penhirai/LinefollowerVerdiRT17_MainPCB/Order/PCBGOGO/20160213/VerdiRT7_MainPCB.jpg

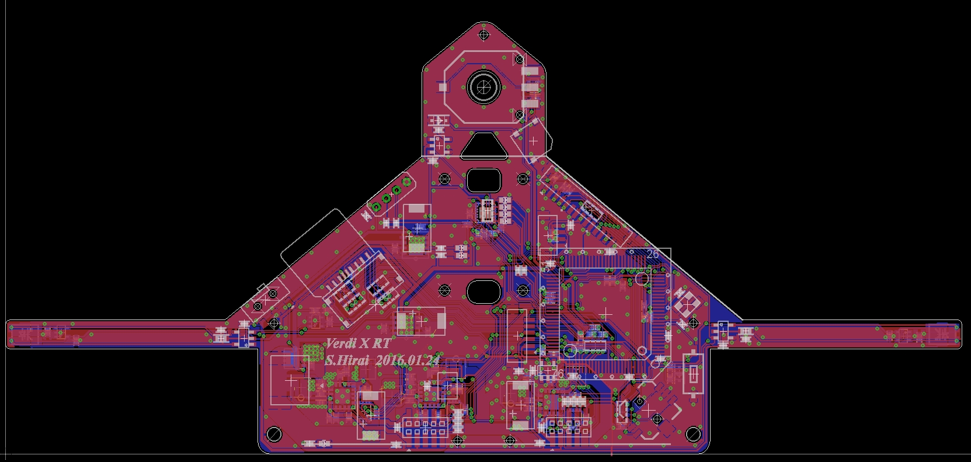
Order/PCBGOGO/20160213/VerdiRT7_MainPCB.jpg
