penhirai/LinefollowerVerdiRT17_MainPCB/README.md

# LinefollowerVerdiRT17_MainPCB
Micromouse Robotrace Competition
