penhirai/LinefollowerVerdiRT17_MainPCB/VerdiRT7_MainPCB_Board.pdf

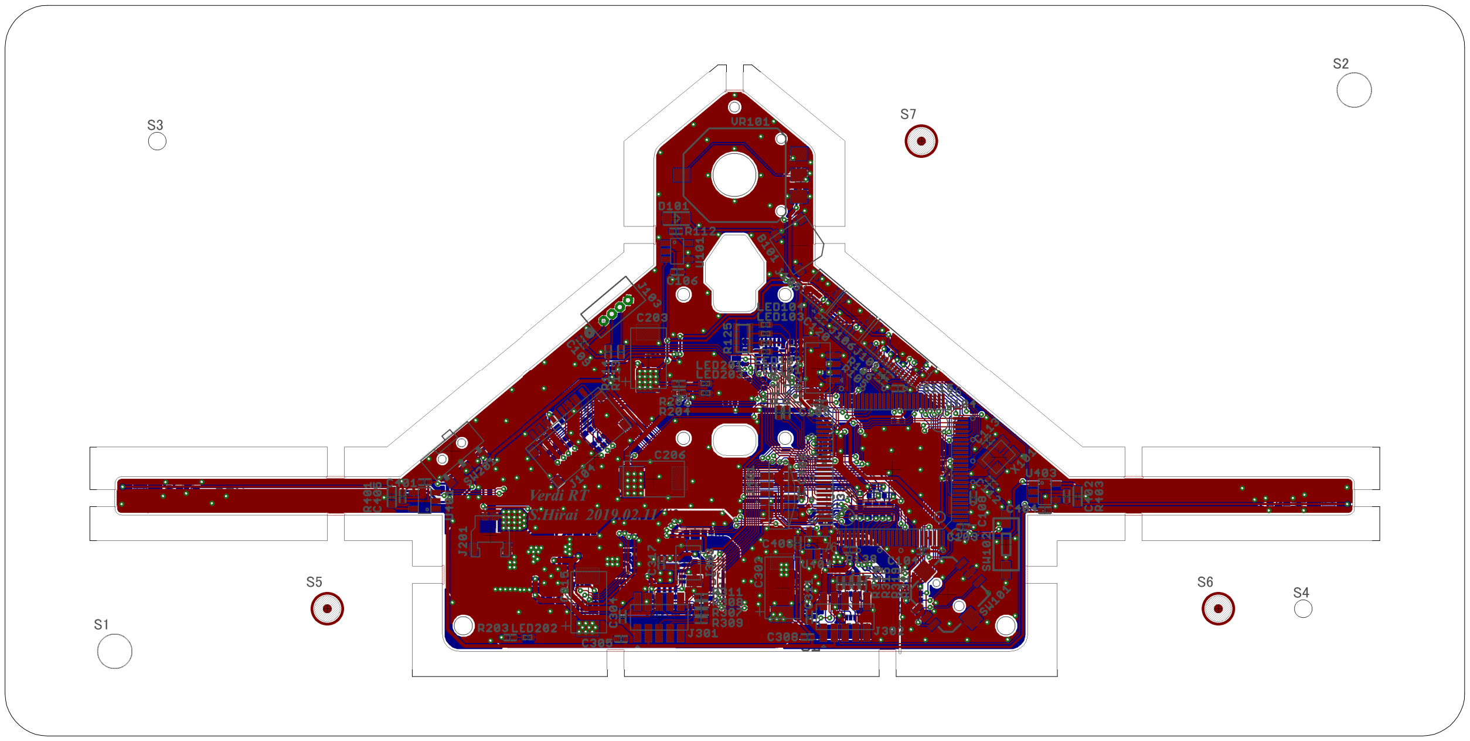
[picture p2: figure]
