penhirai/LinefollowerVerdiRT17_MainPCB/VerdiRT7_MainPCB_GBview_Cmp.png

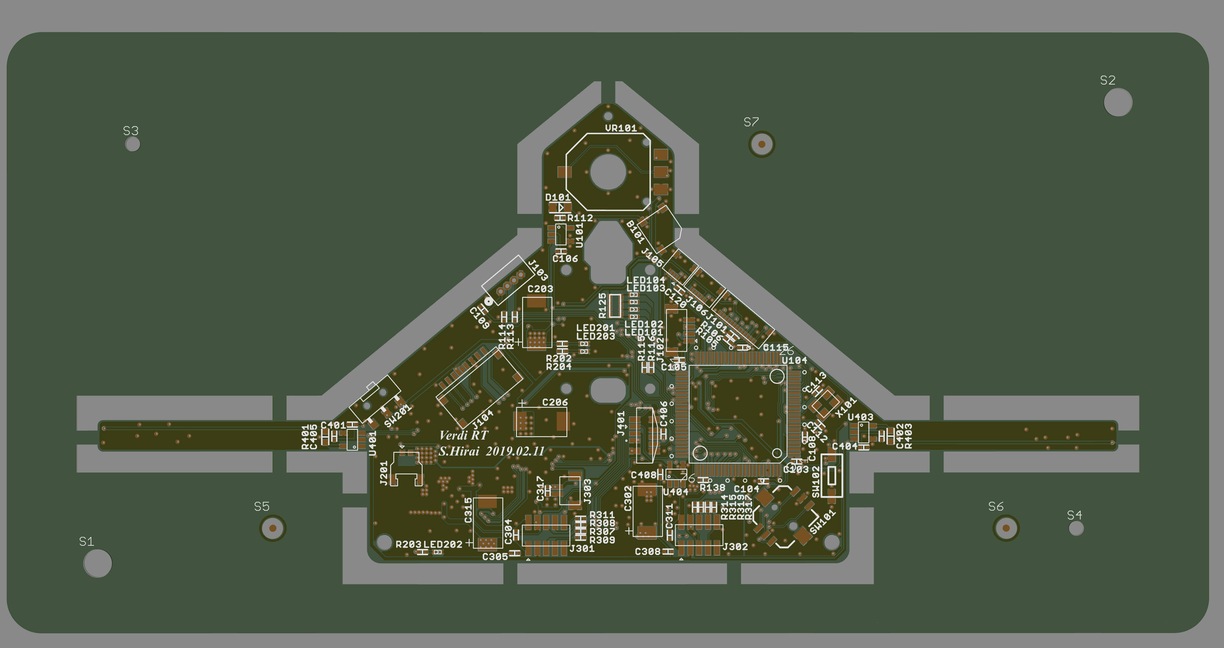
VerdiRT7_MainPCB_GBview_Cmp.png
