penhirai/LinefollowerVerdiRT17_MainPCB/VerdiRT7_MainPCB_GBview_Sol_Mirror.png

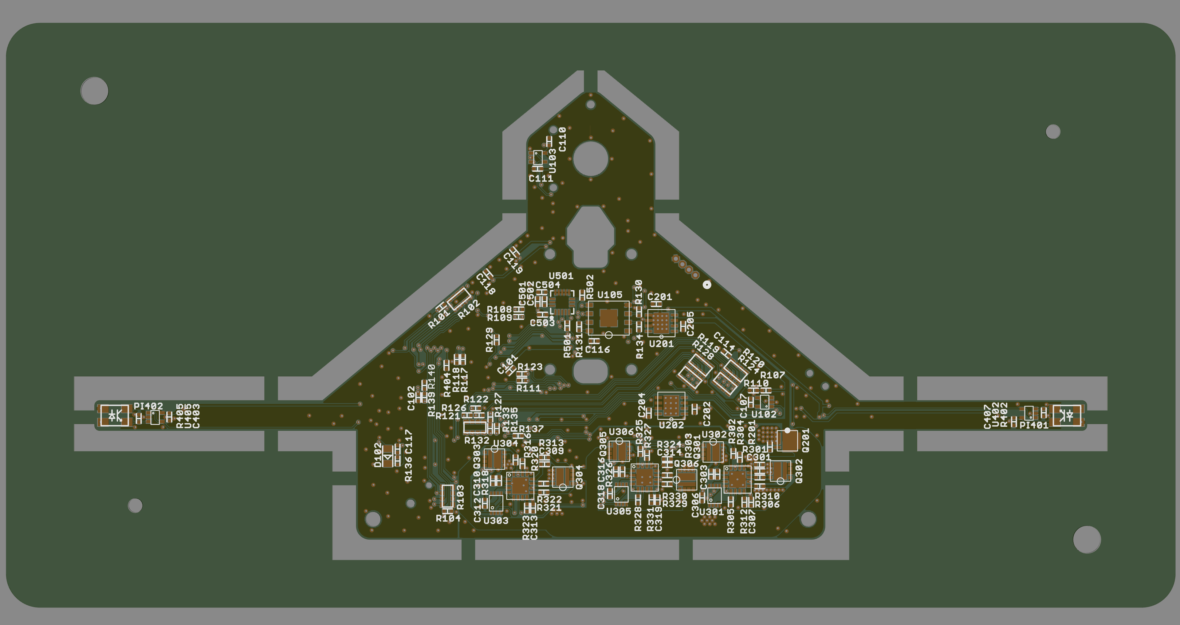
VerdiRT7_MainPCB_GBview_Sol_Mirror.png
