penhirai/LinefollowerVerdiRT17_MainPCB/Order/PCBGOGO/20160213/readme.txt

readme.txt ... 

VerdiRT7_Main.cmp ... pattern component side
VerdiRT7_Main.sol ... pattern solder side
VerdiRT7_Main.stc ... Solder stop component side
VerdiRT7_Main.sts ... Solder stop solder side
VerdiRT7_Main.plc ... Silkscreen component side
VerdiRT7_Main.out ... outline file
VerdiRT7_Main.dri ... Drill table
VerdiRT7_Main.drd ... Drill data

VerdiRT7_Main.jpg ... PCB image
