penhirai/LinefollowerVerdiRT17_MainPCB/Order/PCBGOGO/20190217_Order/Gerber/readme.txt

readme.txt ... 

VerdiRT19_MainPCB.cmp ... pattern component side (L1)
VerdiRT19_MainPCB.sol ... pattern solder side (L2)
VerdiRT19_MainPCB.stc ... Solder stop component side
VerdiRT19_MainPCB.sts ... Solder stop solder side
VerdiRT19_MainPCB.plc ... Silkscreen component side
VerdiRT19_MainPCB.pls ... Silkscreen solder side
VerdiRT19_MainPCB.crc ... Cream component side
VerdiRT19_MainPCB.crs ... Cream solder side
VerdiRT19_MainPCB.out ... outline file
VerdiRT19_MainPCB.dri ... Drill table
VerdiRT19_MainPCB.drd ... Drill data

PositionVerdiRT19_MainPCB.txt ... Mount position component/solder side
BomVerdiRT19_MainPCB.xlsx ... Bom list

VerdiRT19_MainPCB_GBView_Cmp.png        ... Gerber View Component side with Description
VerdiRT19_MainPCB_GBView_Sol_Mirror.png ... Gerber View Solder side with Description

VerdiRT19_MainPCB_Specification.txt ... PCB Specification
