penhirai/LinefollowerVerdiRT17_MainPCB/Order/PCBGOGO/20190217_Order/BomVerdiRT19_MainPCB.xlsx

品名 Name | 部品番号 Designator | 個数 Quantity | 値 Value | パッケージ Package | 説明 Description | 部品メーカー Manufacturer | 部品メーカーの品番 Manufacturer Part Number | 実装 / 非実装 | 代替可否
抵抗 | R112, R304, R308, R310, R311, R315, R317, R320, R322, R327, R330 | 11 | 0 | 1005 |  | KOA | RK73Z1ETTP | 実装 | 可
抵抗 | R307, R309, R314, R319 | 4 | 0 | 1005 |  | KOA | RK73Z1ETTP | 非実装 | 可
抵抗 | R303, R312, R318, R323, R326, R331 | 6 | 1 | 1005 | 1% | KOA | RK73H1ETTP1R00F | 実装 | 可
抵抗 | R103, R119, R120 | 3 | 100k | 3216 | 1% | Bourns | CAT16-1003F4LF | 実装 | 可
抵抗 | R104, R111, R130, R131, R136, R139, R305, R328, R404, R502 | 10 | 100k | 1005 | 1% | KOA | RK73H1ETTP1003F | 実装 | 可
抵抗 | R140 | 1 | 100k | 1005 | 1% | KOA | RK73H1ETTP1003F | 非実装 | 可
コネクタ | J104 | 1 | ー | SMD |  | TE Connectivity | 1050270001 | 実装 | 可
コンデンサ | C101, C102, C103, C104, C105, C107, C108, C109, C110, C111, C114, C115, C116, C201, C204, C306, C312, C318, C401, C403, C404, C406, C407, C408 | 24 | 10V 0.1u | 1005 | 16V X7R 10% | TE Connectivity | GRM155R71C104JA88D | 実装 | 可
コンデンサ | C112, C113 | 2 | 10V 10p | 1005 | 10V CH 10% | TDK | C1005CH1H100C050BA | 実装 | 可
コンデンサ | C106, C117, C118, C120, C305, C308, C402, C405 | 8 | 10V 1u | 1005 | 35V X5R 10% | TDK | C1005X5R1V105K050BC | 実装 | 可
抵抗 | R102, R125 | 2 | 10k | 3216 | 1% | Bourns | CAT16-1002F4LF | 実装 | 可
抵抗 | R101, R105, R106, R110 | 4 | 10k | 1005 | 1% | KOA | RK73H1ETTP1002F | 実装 | 可
コンデンサ | C202, C205 | 2 | 16V 0.1u | 1005 | 16V X7R 10% | Murata | GRM155R71C104JA88D | 実装 | 可
コンデンサ | C119, C301, C303, C307, C309, C310, C313, C314, C316, C319 | 10 | 16V 1u | 1005 | 35V X5R 10% | TDK | C1005X5R1V105K050BC | 実装 | 可
ダイオード | D101, D102 | 2 | ー | 2012 |  | Toshiba | 1SS352 | 実装 | 可
抵抗 | R301, R302, R306, R313, R316, R321, R324, R325, R329 | 9 | 2.2 | 1005 | 1% | KOA | RK73H1ETTP2R20F | ー | 可
コネクタ | J301, J302 | 2 | ー | SMD |  | Amphenol ICC (FCI) | 20021321-00010C4LF | 実装 | 可
抵抗 | R107, R201 | 2 | 20k | 1005 | 1% | KOA | RK73H1ETTP2002F | ー | 可
抵抗 | R108, R109, R113, R114 | 4 | 20k | 1005 | 1% | KOA | RK73H1ETTP2002F | 非実装 | 可
抵抗 | R124, R128, R132 | 3 | 22 | 3216 | 1% | Bourns | CAT16-22R0F4LF | 実装 | 可
抵抗 | R115, R116, R121, R122, R126, R127, R129, R133, R134, R135, R137, R138, R501 | 13 | 22 | 1005 | 1% | KOA | RK73H1ETTP22R0F | 実装 | 可
抵抗 | R117, R118, R123 | 3 | 22 | 1005 | 1% | KOA | RK73H1ETTP22R0F | 非実装 | 可
抵抗 | R402, R405 | 2 | 3k | 1005 | 1% | KOA | RK73H1ETTP3001F | ー | 可
抵抗 | R202, R203, R204 | 3 | 4.7k | 1005 | 1% | KOA | RK73H1ETTP4701F | ー | 可
コネクタ | J105 | 1 | ー | SMD |  | Molex | 503480-0400 | ー | 不可
コネクタ | J106 | 1 | ー | SMD |  | Molex | 503480-0600 | 実装 | 不可
コネクタ | J101 | 1 | ー | SMD |  | Molex | 503480-1400 | ー | 不可
コンデンサ | C304, C311, C317 | 3 | 50V 0.01u | 1005 | 50V X7R 10% | Murata | GRM155R71H103KA88D | 実装 | 可
抵抗 | R401, R403 | 2 | 51 | 1608 | 1% | KOA | RK73H1JTTD51R0F | 実装 | 可
コネクタ | J401 | 1 | ー | SMD |  | Molex | 52559-0652 | 実装 | 不可
コンデンサ | C502, C503, C504 | 3 | 6.3V 0.1u | 1005 | 16V X7R 10% | Murata | GRM155R71C104JA88D | 実装 | 可
コンデンサ | C501 | 1 | 6.3V 1u | 1005 | 35V X5R 10% | TDK | C1005X5R1V105K050BC | 実装 | 可
ロジックIC | U301, U303, U305 | 3 | ー | VSSOP8 |  | Nexperia | 74LVC2G08DC | 実装 | 不可
LED | LED101, LED102, LED103, LED104 | 4 | ー | 1005 |  | Kingbright | APHHS1005QBC/D | 実装 | 可
LED | LED201, LED203 | 2 | ー | 1005 |  | Kingbright | APHHS1005SYCK | 実装 | 可
LED | LED202 | 1 | ー | 1005 |  | Kingbright | APHHS1005ZGC | 実装 | 可
スイッチ | SW201 | 1 | ー | SMD |  | C&K | AYZ0102AGRLC | 実装 | 不可
基準穴 | S1, S2 | 2 | ー | ー | BASE_HOLE | ー | BASE_HOLE | ー | ー
コネクタ | J303 | 1 | ー | SMD |  | JST | BM02B-SRSS-TB(LF)(SN) | 実装 | 不可
コネクタ | J102 | 1 | ー | SMD |  | JST | BM04B-SRSS-TB(LF)(SN) | 実装 | 不可
コネクタ | J103 | 1 | ー | SMD |  | Hirose | DF13-4P-1.25DSA | 非実装 | 不可
コネクタ | J201 | 1 | ー | SMD |  | Hirose | DF58-2P-1.2V(21) | 実装 | 不可
コンデンサ | C203, C206, C302, C315 | 4 | 16V 33u | 7343 | 20% | Panasonic | EEF-CS1C330R | 実装 | 不可
フォトインタラプタ | PI401, PI402 | 2 | ー | SMD |  | Sharp | GP2S700HCP | 実装 | 不可
ガイド穴 | S3 | 1 | ー | ー | GUIDE_HOLE_1 | ー | GUIDE_HOLE_1 | ー | ー
ガイド穴 | S4 | 1 | ー | ー | GUIDE_HOLE_2 | ー | GUIDE_HOLE_2 | ー | ー
MEMS ジャイロ | U501 | 1 | ー | LGA16_3X3MM |  | TDK Invensense | ICM-20602 | 実装 | 不可
ゲートドライバ | U101, U401, U403, U404 | 4 | ー | SOT23-5 |  | Microchip | MCP1416T-E/OT | 実装 | 不可
オペアンプ | U102, U103, U402, U405 | 4 | ー | SOT-70-5 |  | Microchip | MCP6001T-I/LT | 実装 | 不可
メモリ | U105 | 1 | ー | 8DFN |  | Everspin | MR20H40CDF | 実装 | 不可
水晶振動子 | X101 | 1 | ー | 3225 |  | NDK | NX3225SA-12.000M-STD-CSR-1 | 実装 | 不可
マイコン | U104 | 1 | ー | TQFP100-16X16 |  | Renesas | R5F564MLDDFP#V1-ND | 実装 | 不可
認識マーク | S5 | 1 | ー | ー | RECOG_MARK_1 | ー | RECOG_MARK_1 | ー | ー
認識マーク | S6 | 1 | ー | ー | RECOG_MARK_2 | ー | RECOG_MARK_2 | ー | ー
認識マーク | S7 | 1 | ー | ー | RECOG_MARK_3 | ー | RECOG_MARK_3 | ー | ー
ゲートドライバ | U302, U304, U306 | 3 | ー | WQFN16 |  | Richtek | RT9625AZQW | 実装 | 不可
MOSFET | Q201 | 1 | ー | POWERPAK1212-8 |  | Vishay | SISA01DN-T1-GE3 | 実装 | 不可
MOSFET | Q301, Q302, Q303, Q304, Q305, Q306 | 6 | ー | DFN3X3A |  | Vishay | SIZ322DT-T1-GE3 | 実装 | 不可
スイッチ | SW102 | 1 | ー | SMD |  | Alps | SKQYACE010 | 実装 | 不可
スイッチ | SW101 | 1 | ー | SMD |  | Alps | SKRHABE010 | 実装 | 不可
ブザー | B101 | 1 | ー | SMD |  | PUI Audio | SMT-0540-T-7-R | 実装 | 不可
可変抵抗 | VR101 | 1 | ー | SMD |  | Murata | SV01A103AEA01 | 実装 | 不可
電源 IC | U202 | 1 | ー | WFDFN8 |  | Texas Instruments | TLV1117-33CDRJR | 実装 | 不可
電源 IC | U201 | 1 | ー | WFDFN8 |  | Texas Instruments | TLV1117-50CDRJR | 実装 | 不可
