penhirai/LinefollowerVerdiRT17_MainPCB/VerdiRT7_MainPCB.pdf

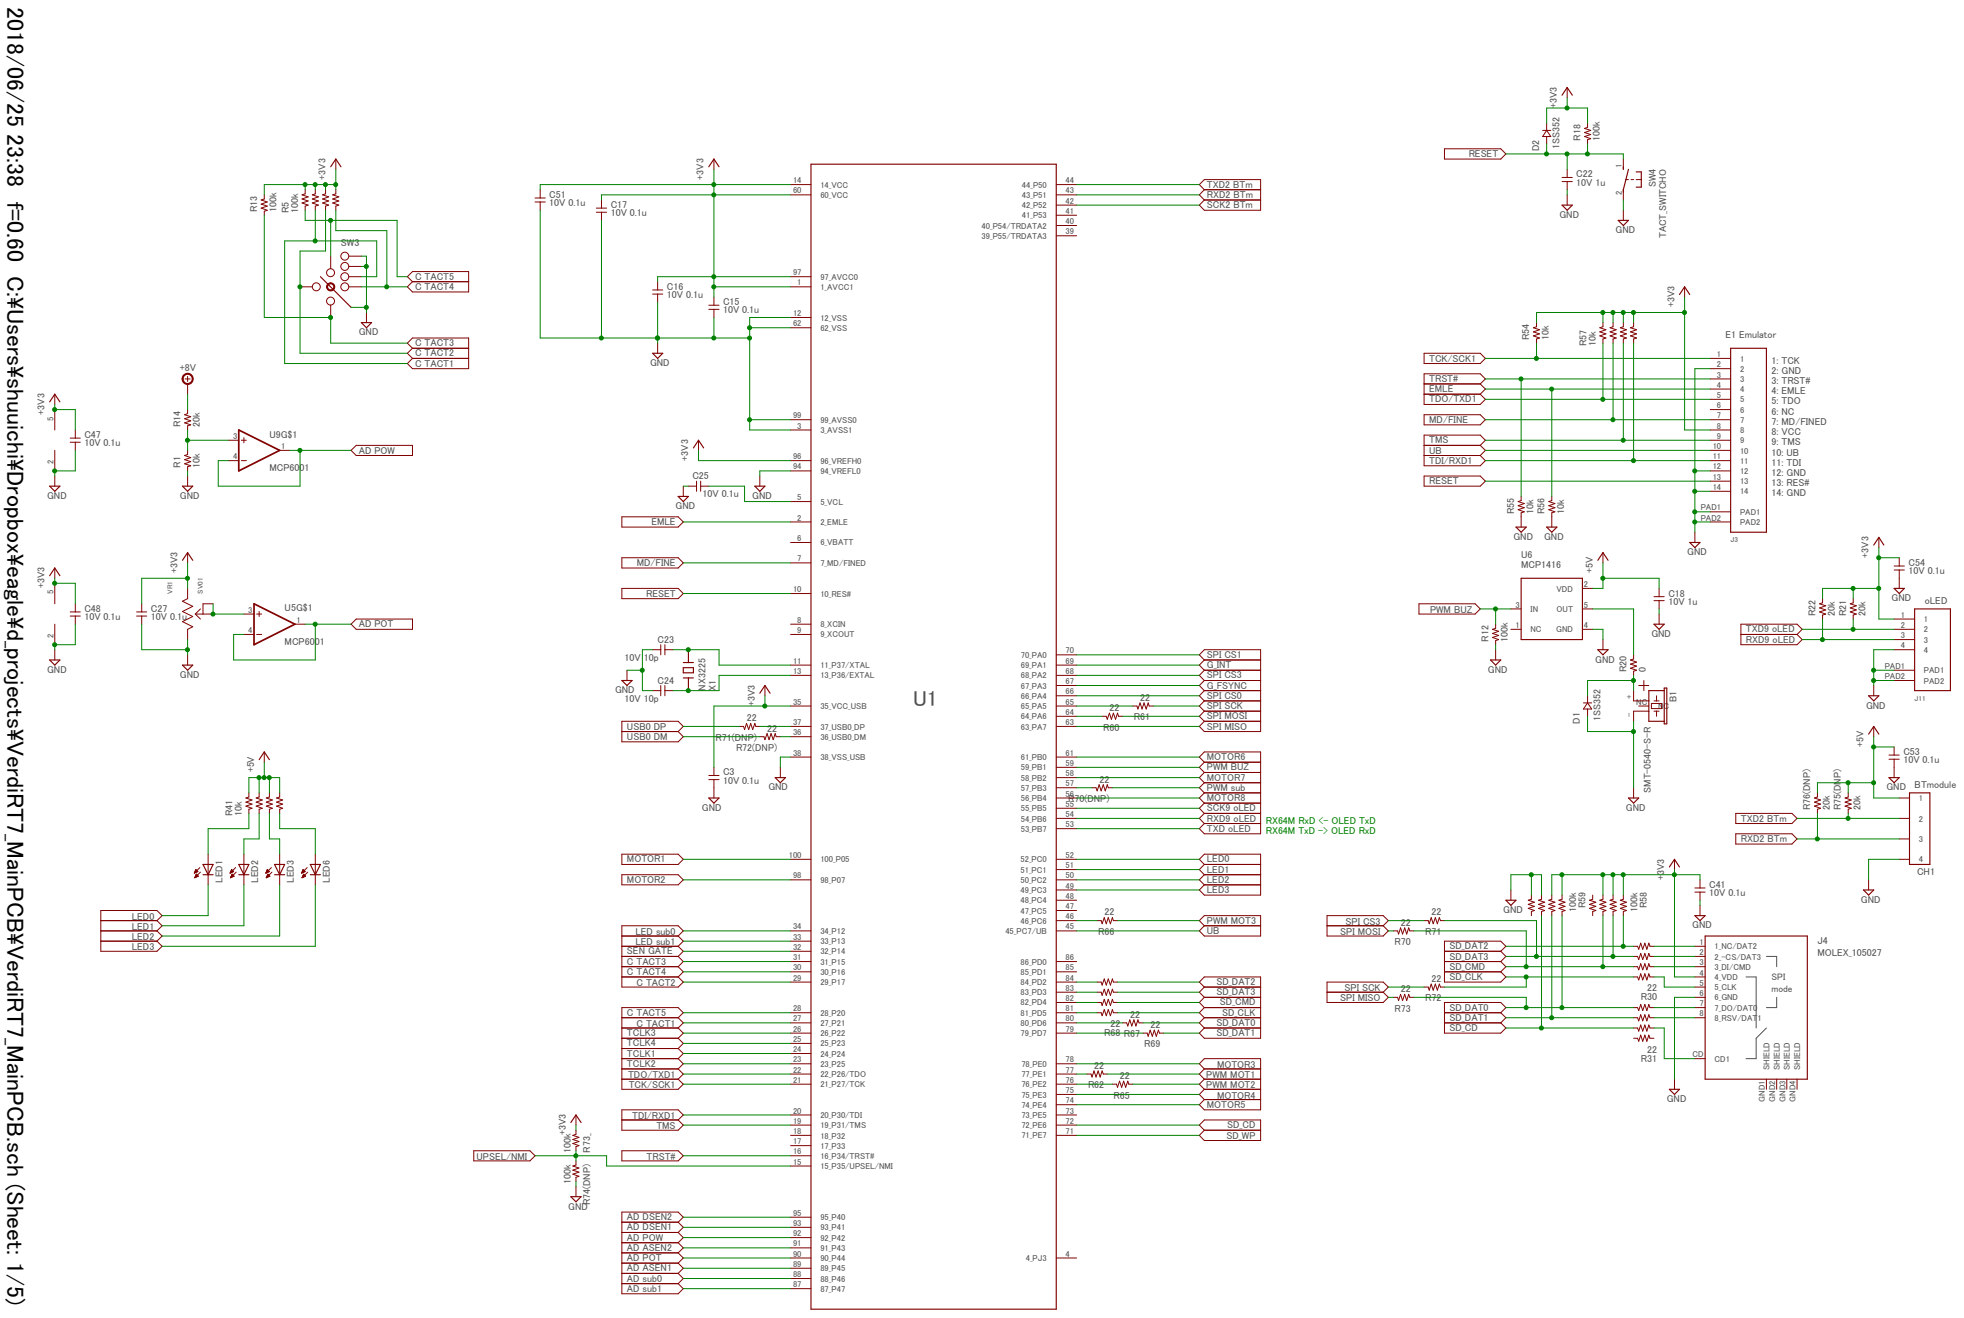
[picture p5: page 1]

2018/06/25 23:38 f=0.60 C:\Users\shuuichi\Dropbox\eagle\d_projects\VerdiRT7_MainPCB\VerdiRT7_MainPCB.sch (Sheet: 1/5) oLED E1 Emulator1: TCK 2: GND 3: TRST# 4: EMLE 5: TDO 6: NC 7: MD/FINED 8: VCC 9: TMS 10: UB 11: TDI 12: GND 13: RES# 14: GND BTmodule SPI mode

TXD9 oLED RXD9 oLED | 3 4

USB0 DM | 38_VSS_USB 38

# VCC

+8V

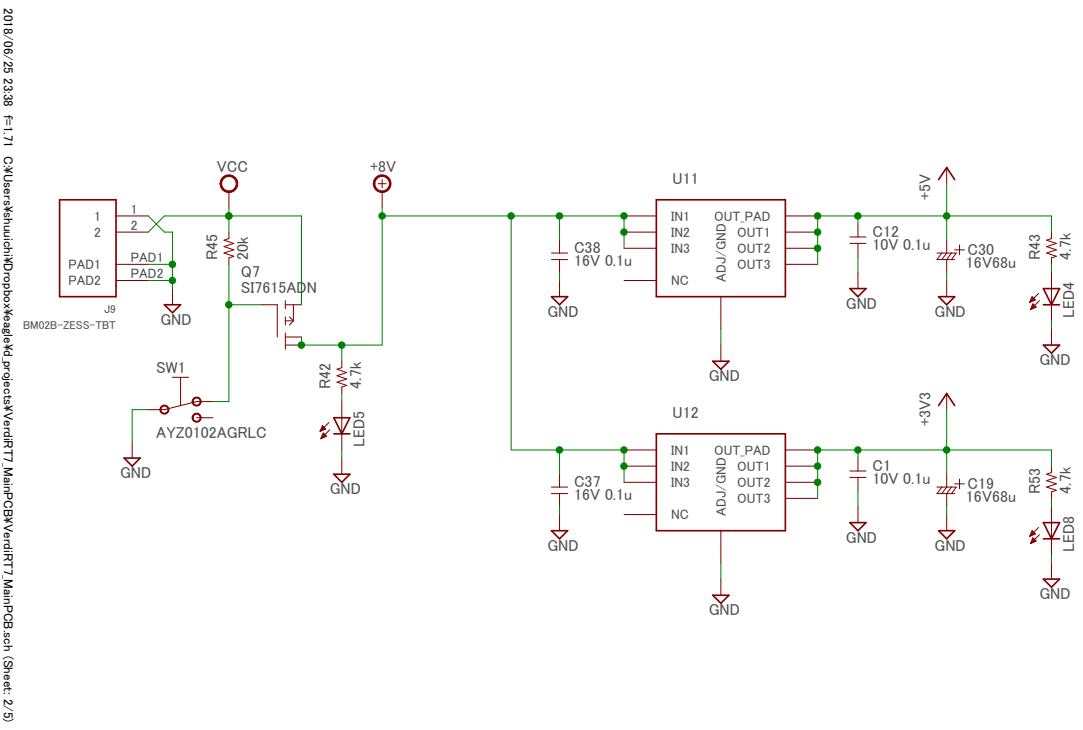
[picture p6: page 2]

2018/06/25 23:38 f=1.71 C:\Users\shuuichi\Dropbox\eagle\d_projects\VerdiRT7_MainPCB\VerdiRT7_MainPCB.sch (Sheet: 2/5) 16V 0.1u

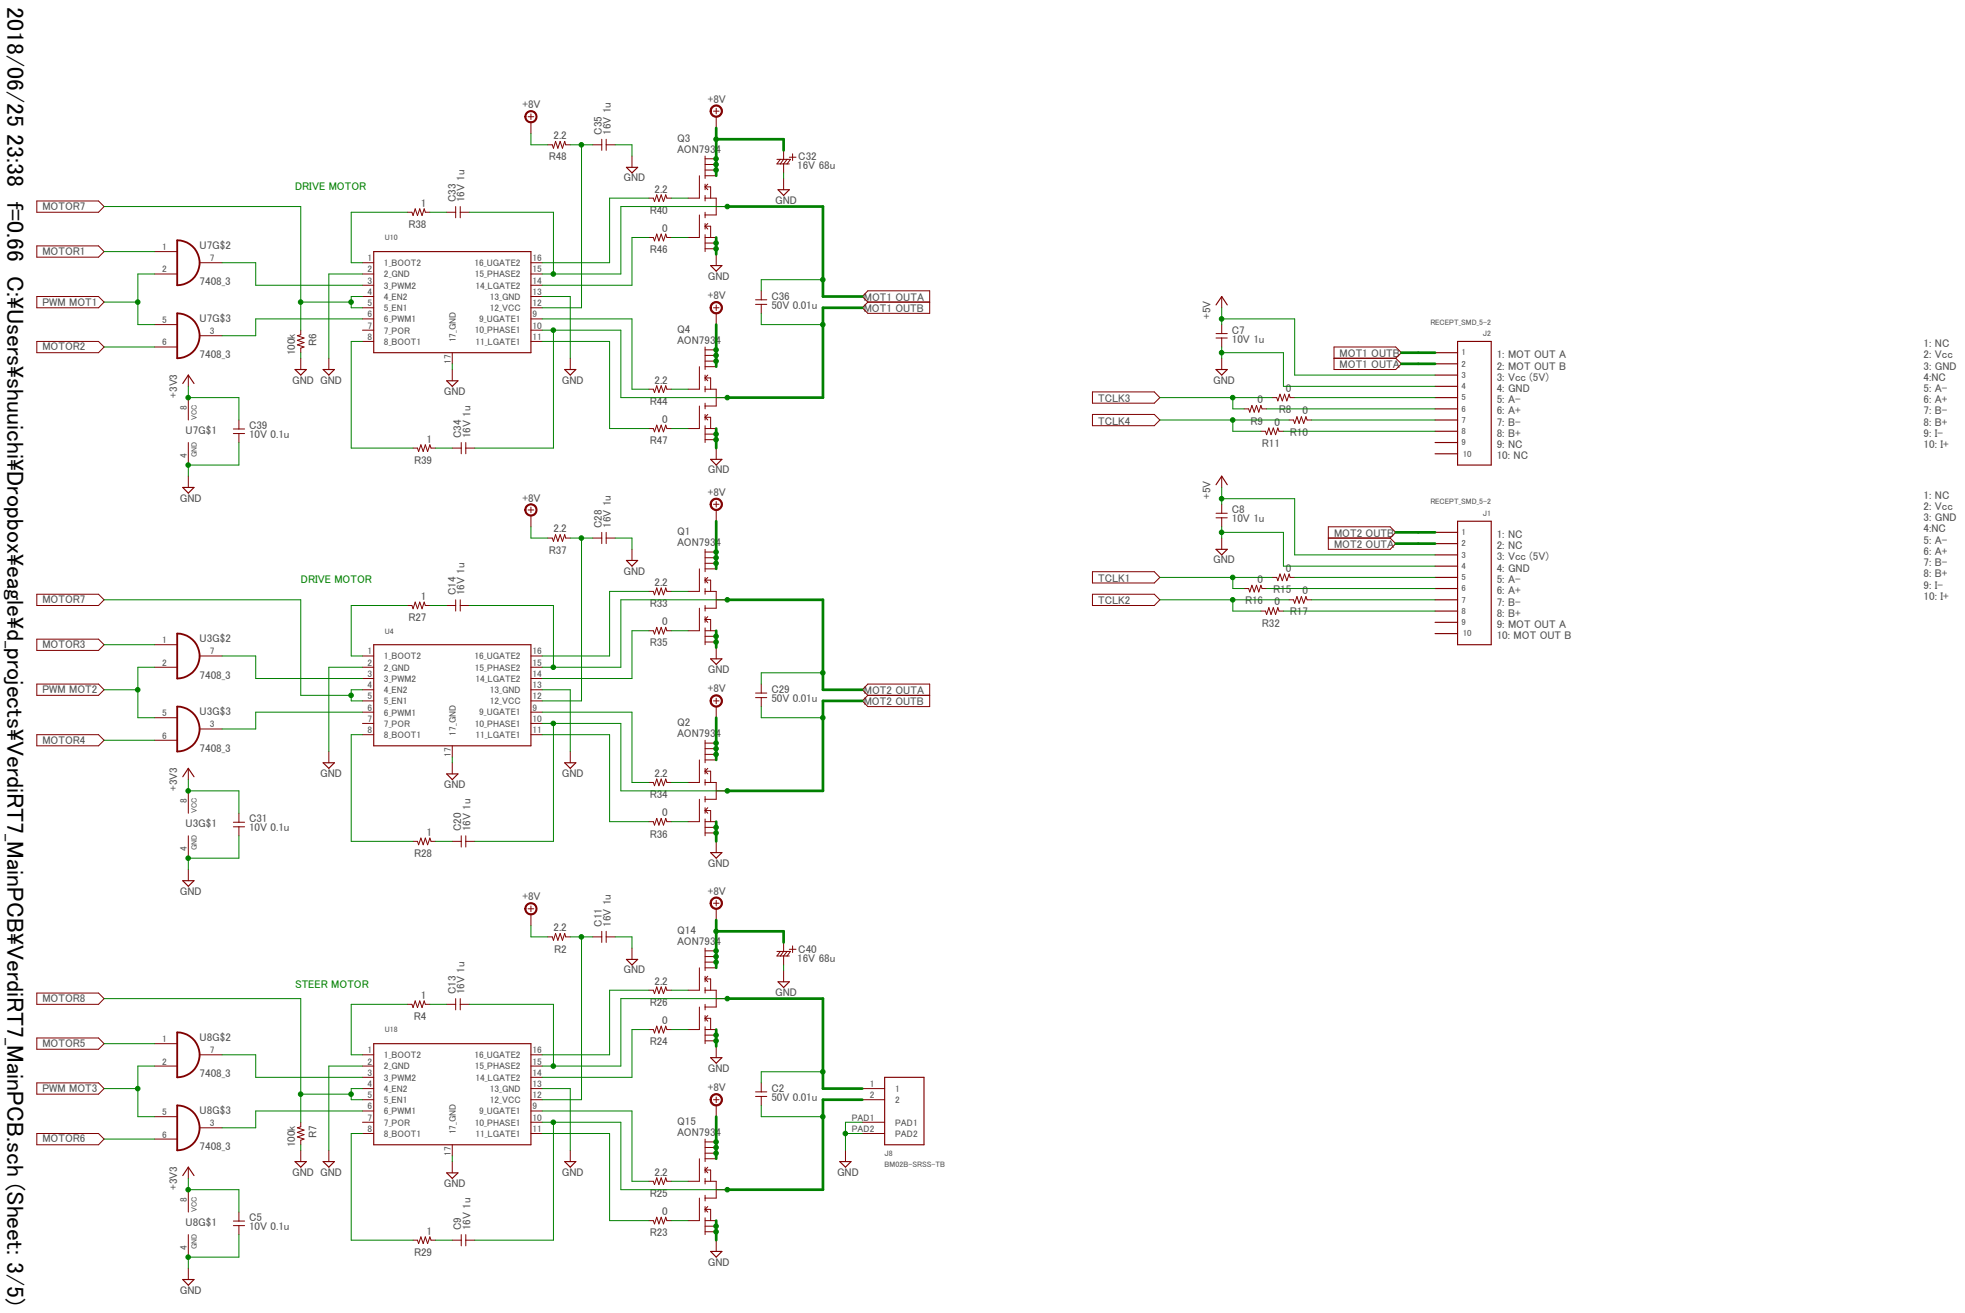
[picture p7: page 3]

2018/06/25 23:38 f=0.66 C:\Users\shuuichi\Dropbox\eagle\d_projects\VerdiRT7_MainPCB\VerdiRT7_MainPCB.sch (Sheet: 3/5) 1: NC 2: Vcc 3: GND 4:NC 5: A- 6: A+ 7: B- 8: B+ 9: I- 10: I+ 1: NC 2: Vcc 3: GND 4:NC 5: A- 6: A+ 7: B- 8: B+ 9: I- 10: I+ 3: Vcc (5V) 4: GND 5: A- 6: A+ 7: B- 8: B+ 2: MOT OUT B 1: MOT OUT A 9: NC 10: NC 3: Vcc (5V) 4: GND 5: A- 6: A+ 7: B- 8: B+ 2: NC 1: NC 9: MOT OUT A 10: MOT OUT B PWM MOT1 MOTOR5 MOTOR6 PWM MOT3 16V 68u BM02B-SRSS-TB GND

R6 R7 STEER MOTOR DRIVE MOTOR

10V 1u

C6

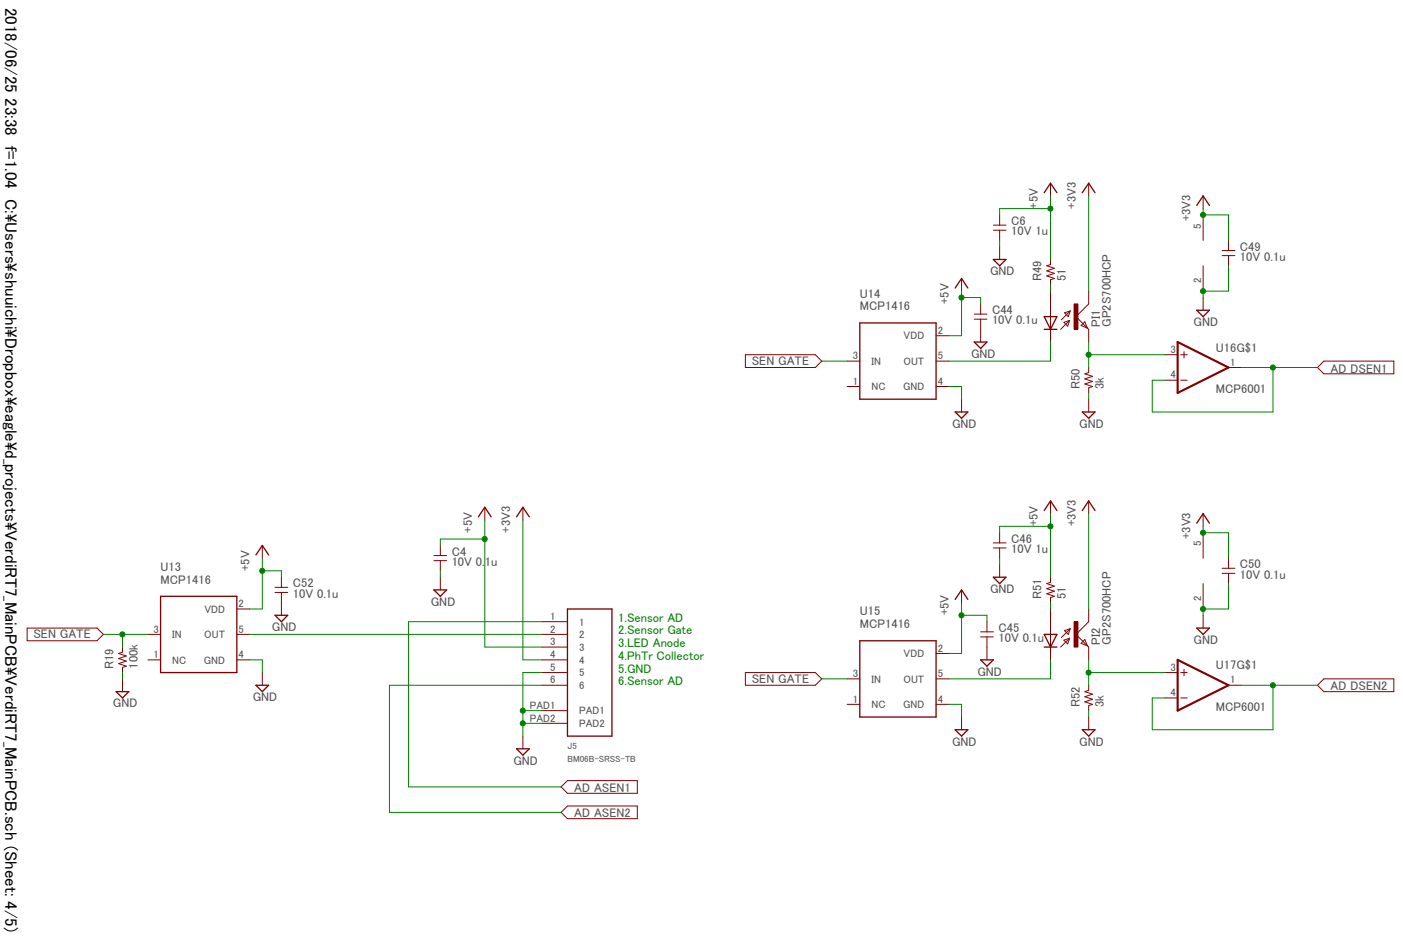
[picture p8: page 4]

2018/06/25 23:38 f=1.04 C:\Users\shuuichi\Dropbox\eagle\d_projects\VerdiRT7_MainPCB\VerdiRT7_MainPCB.sch (Sheet: 4/5) 10V 0.1u SEN GATE AD ASEN1 AD ASEN2

2018/06/25 23:38 f=1.75 C:\Users\shuuichi\Dropbox\eagle\d_projects\VerdiRT7_MainPCB\VerdiRT7_MainPCB.sch (Sheet: 5/5) GND 6.3V 1u GND

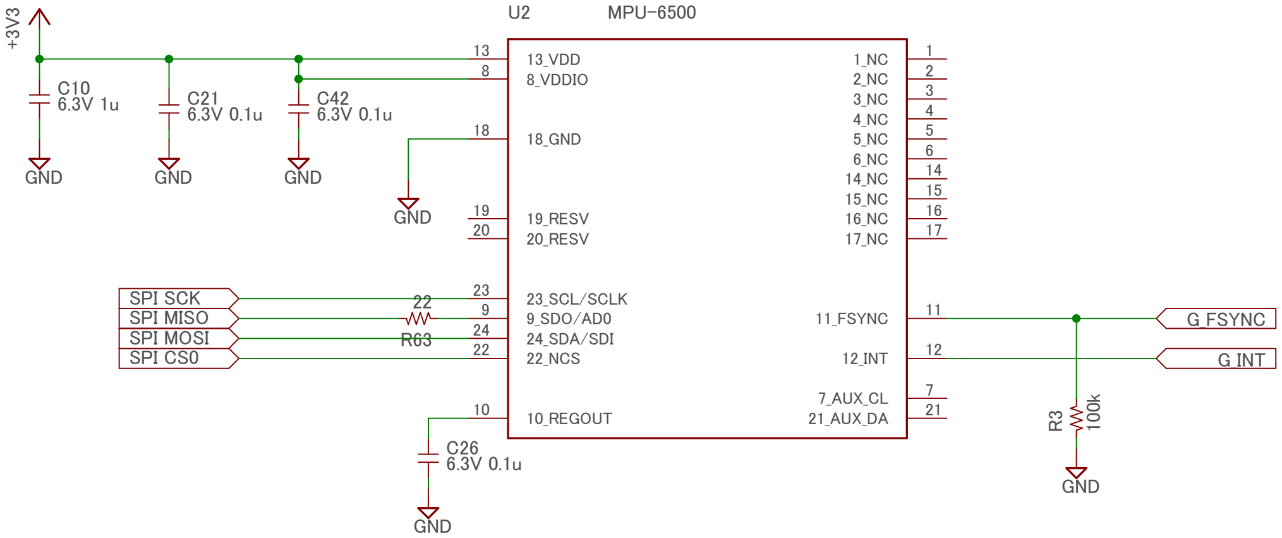
[picture p9: figure]
MPU-6500; SPI CS0; SPI SCK; SPI MOSI; SPI MISO; GND; G_FSYNC; G_INT; 9_SDO/AD0; 19_RESV 19; 2 8_VDDIO; 20_RESV 20; 24_SDA/SDI 24; 22_NCS 22; 23_SCL/SCLK 23; 10_REGOUT 10; 11_FSYNC; 13_VDD 13; 21_AUX_DA; 7_AUX_CL; 18_GND 18; 12_INT
