penhirai/LinefollowerVerdiRT17_MainPCB/VerdiRT7_MainPCB_Schematic.pdf

## R5F564MLDDFP#V1-ND

U104

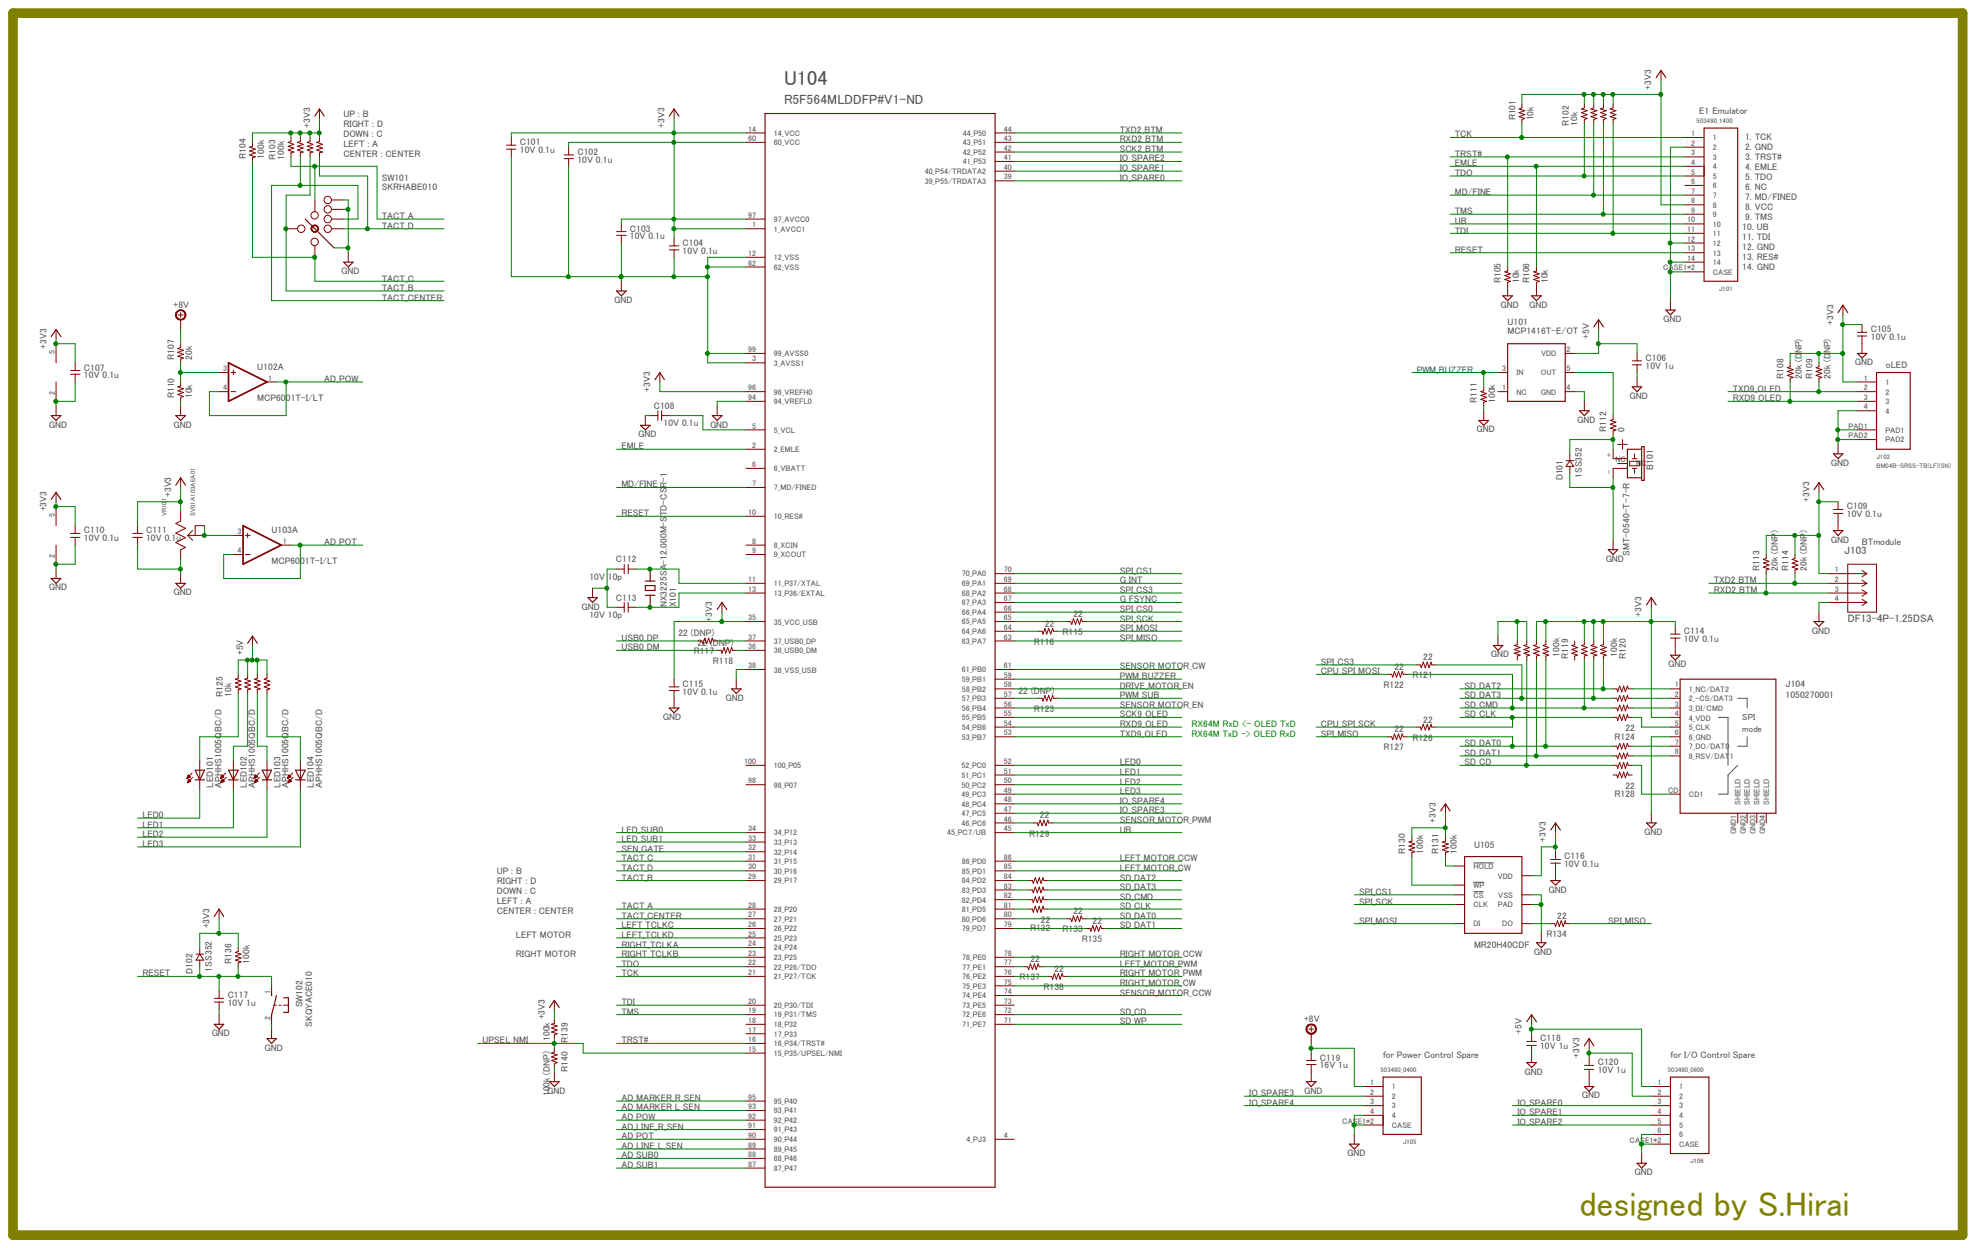
[picture p10: page 1]

BM04B-SRSS-TB(LF)(SN)
