penhirai/LinefollowerVerdiRT17_MainPCB/VerdiRT7_MainPCB.brd

## EAGLE design VerdiRT7_MainPCB.brd (2019-02-17)

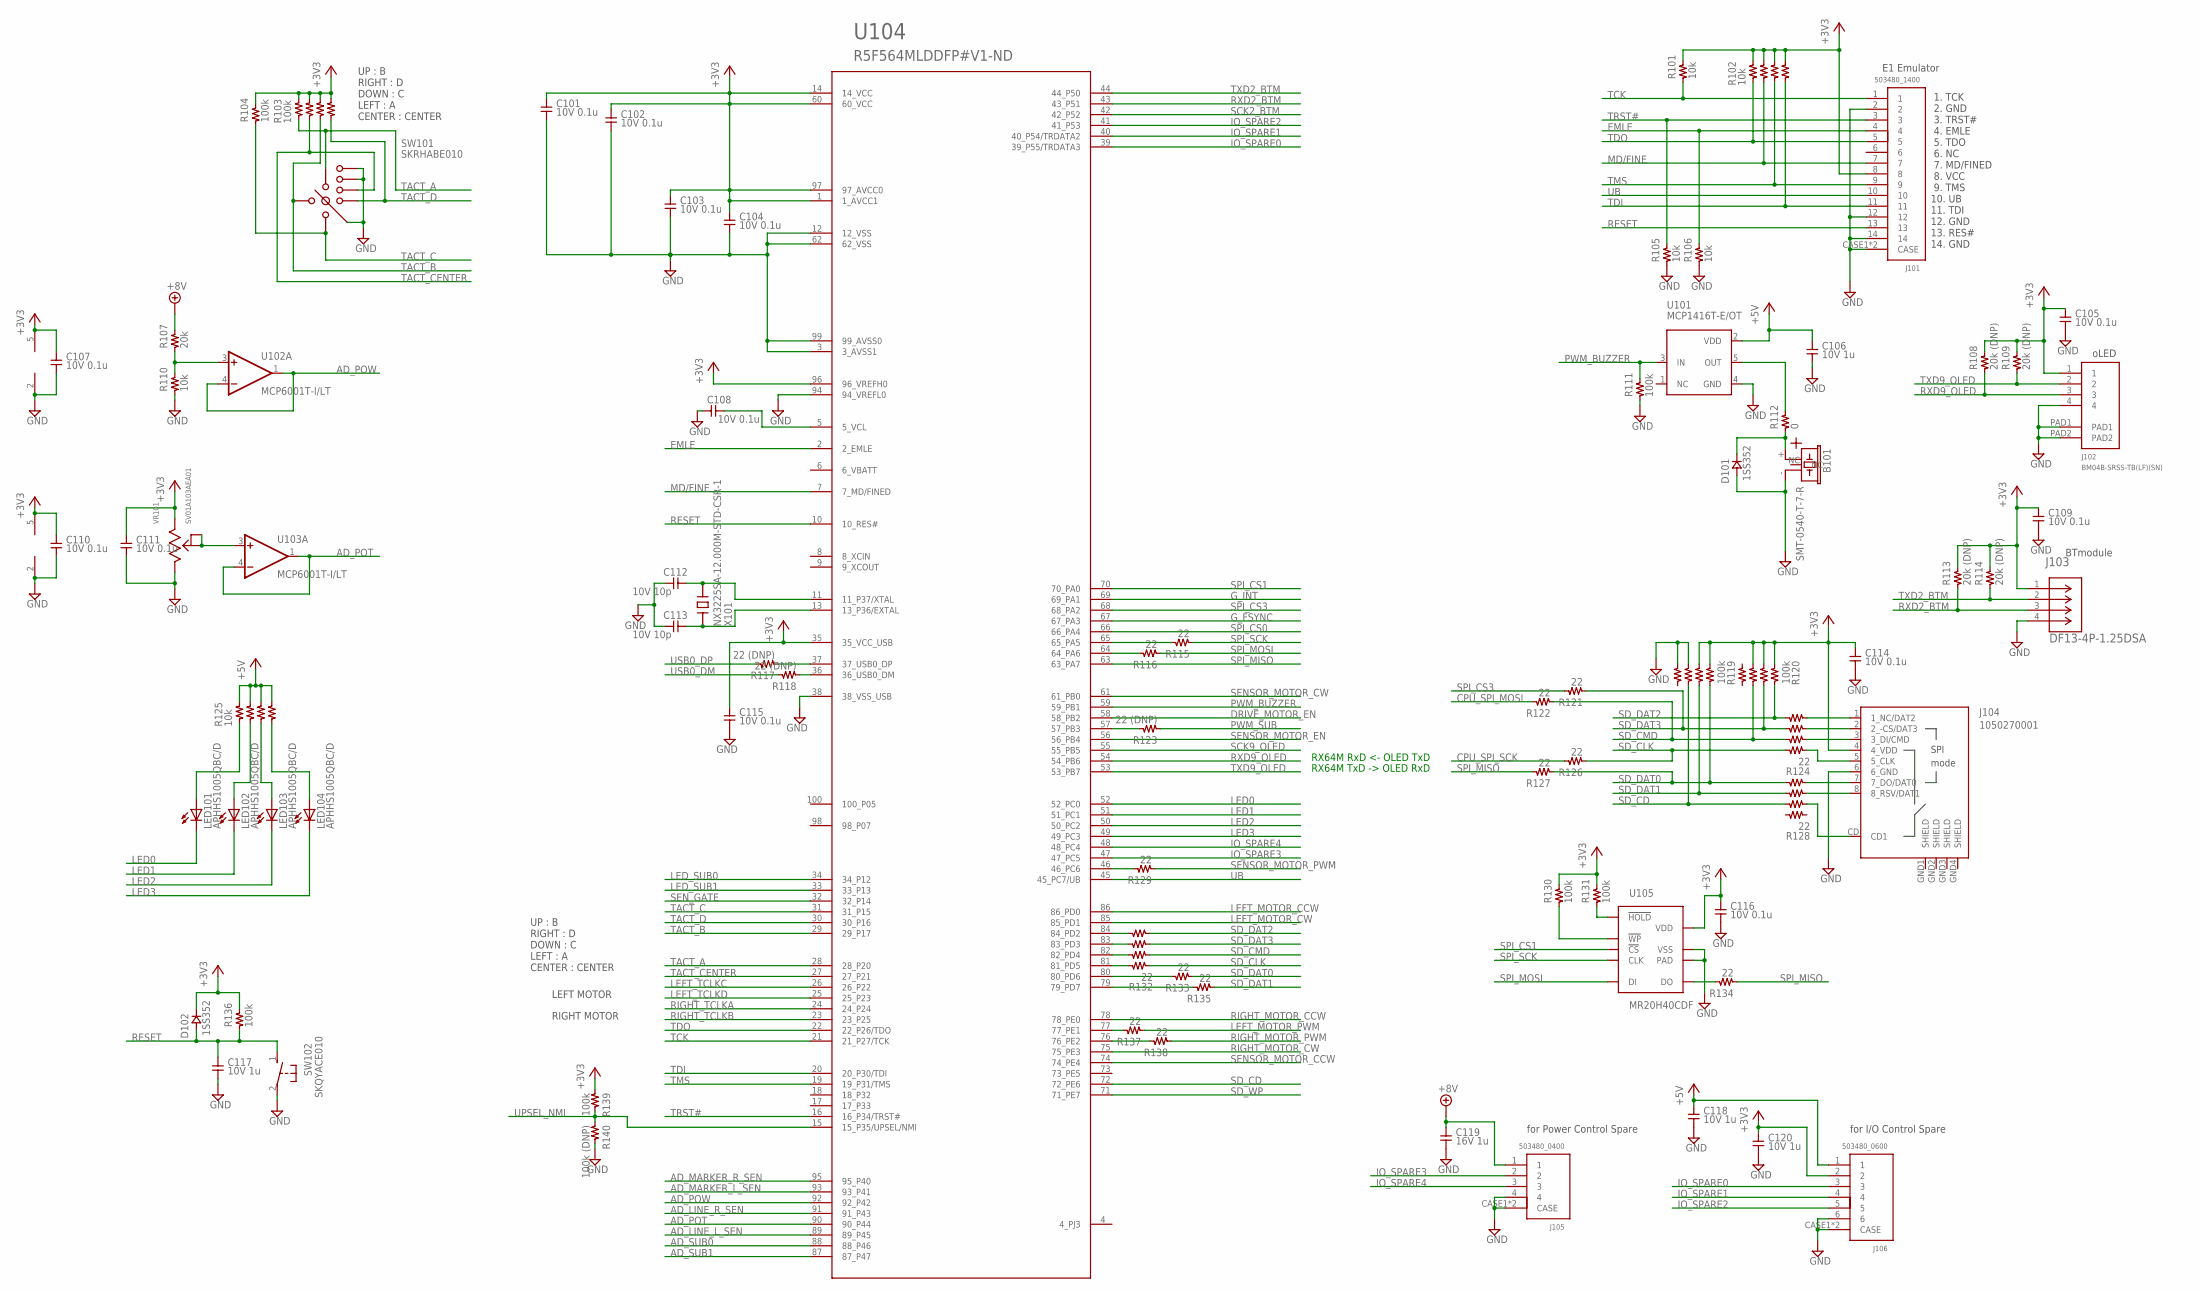
[picture p11: schematic VerdiRT7_MainPCB.sch, sheet 1]

Parts:
B101: SMT-0540-T-7-R; SMT-0540-S-R
C101, C102, C103, C104, C105, C107, C108, C109, C110, C111, C114, C115, C116: 10V 0.1u; 1005
C106, C117, C118, C120: 10V 1u; 1005
C112, C113: 10V 10p; 1005
C119: 16V 1u; 1005
D101, D102: 1SS352; 2012
J101: 503480_1400; 1400
J102: BM04B-SRSS-TB(LF)(SN); BM04B-SRSS-TB
J103: DF13-4P-1.25DSA; DF13_4P_TH
J104: 1050270001; MOLEX_105027
J105: 503480_0400; 0400
J106: 503480_0600; 0600
LED101, LED102, LED103, LED104: APHHS1005QBC/D; 1005
R101, R105, R106, R110: 10k; 1005
R102, R125: 10k; 3216_ARRAY
R103, R119, R120: 100k; 3216_ARRAY
R104, R111, R130, R131, R136, R139: 100k; 1005
R107: 20k; 1005
R108, R109, R113, R114: 20k (DNP); 1005
R112: 0; 1005
R115, R116, R121, R122, R126, R127, R129, R133, R134, R135, R137, R138: 22; 1005
R117, R118, R123: 22 (DNP); 1005
R124, R128, R132: 22; 3216_ARRAY
R140: 100k (DNP); 1005
SW101: SKRHABE010; SKRH
SW102: SKQYACE010; SKQYA
U101: MCP1416T-E/OT; SOT23-5
U102, U103: MCP6001T-I/LT; SOT-70-5
U104: R5F564MLDDFP#V1-ND; TQFP100-16X16
U105: MR20H40CDF; 8DFN
VR101: SV01A103AEA01; SV01
X101: NX3225SA-12.000M-STD-CSR-1; 3225

Connections:
+3V3: C101.P$1, C102.P$1, C103.P$1, C104.P$1, C105.P$1, C107.P$1, C109.P$1, C110.P$1, C111.P$1, C114.P$1, C115.P$1, C116.P$1, C120.P$1, D102.K, J101.8, J102.1, J103.1, J104.4 (4_VDD), J106.2, R101.P$2, R102.R1-B, R102.R2-B, R102.R3-B, R102.R4-B, R103.R1-B, R103.R2-B, R103.R3-B, R103.R4-B, R104.P$2, R108.P$2, R109.P$2, R113.P$2, R114.P$2, R119.R1-A, R119.R2-A, R120.R1-A, R120.R2-A, R120.R3-A, R130.P$2, R131.P$2, R136.P$2, R139.P$1, U102.5 (V+), U103.5 (V+), U104.1 (1_AVCC1), U104.14 (14_VCC), U104.35 (35_VCC_USB), U104.60 (60_VCC), U104.96 (96_VREFH0), U104.97 (97_AVCC0), U105.8 (VDD), VR101.2; also elsewhere on the board
+5V: C106.P$1, C118.P$1, J106.1, R125.R1-B, R125.R2-B, R125.R3-B, R125.R4-B, U101.2 (VDD); also elsewhere on the board
+8V: C119.P$1, J105.1, R107.P$2; also elsewhere on the board
AD_LINE_L_SEN: U104.89 (89_P45); also elsewhere on the board
AD_LINE_R_SEN: U104.91 (91_P43); also elsewhere on the board
AD_MARKER_L_SEN: U104.93 (93_P41); also elsewhere on the board
AD_MARKER_R_SEN: U104.95 (95_P40); also elsewhere on the board
AD_POT: U103.1 (OUT), U103.4 (-IN), U104.90 (90_P44)
AD_POW: U102.1 (OUT), U102.4 (-IN), U104.92 (92_P42)
AD_SUB0: U104.88 (88_P46)
AD_SUB1: U104.87 (87_P47)
CPU_SD_DAT0: R133.P$2, U104.80 (80_PD6)
CPU_SPI_MOSI: R116.P$2, R122.P$2, U104.64 (64_PA6)
CPU_SPI_SCK: R115.P$2, R126.P$2, U104.65 (65_PA5)
DRIVE_MOTOR_EN: U104.58 (58_PB2); also elsewhere on the board
EMLE: J101.4, R106.P$2, U104.2 (2_EMLE)
GND: B101.-, C101.P$2, C102.P$2, C103.P$2, C104.P$2, C105.P$2, C106.P$2, C107.P$2, C108.P$2, C109.P$2, C110.P$2, C111.P$2, C112.P$2, C113.P$2, C114.P$2, C115.P$2, C116.P$2, C117.P$2, C118.P$2, C119.P$2, C120.P$2, D101.A, J101.2, J101.12, J101.14, J101.CASE1 (CASE), J101.CASE2 (CASE), J102.4, J102.PAD1, J102.PAD2, J103.4, J104.6 (6_GND), J105.4, J105.CASE1 (CASE), J105.CASE2 (CASE), J106.6, J106.CASE1 (CASE), J106.CASE2 (CASE), R105.P$1, R106.P$1, R110.P$1, R111.P$1, R119.R3-A, R119.R4-A, R140.P$2, SW101.1, SW101.2, SW101.COMMON, SW102.2, U101.4 (GND), U102.2 (V-), U103.2 (V-), U104.3 (3_AVSS1), U104.12 (12_VSS), U104.38 (38_VSS_USB), U104.62 (62_VSS), U104.94 (94_VREFL0), U104.99 (99_AVSS0), U105.4 (VSS), U105.PAD, VR101.1; also elsewhere on the board
G_FSYNC: U104.67 (67_PA3); also elsewhere on the board
G_INT: U104.69 (69_PA1); also elsewhere on the board
IO_SPARE0: J106.3, U104.39 (39_P55/TRDATA3)
IO_SPARE1: J106.4, U104.40 (40_P54/TRDATA2)
IO_SPARE2: J106.5, U104.41 (41_P53)
IO_SPARE3: J105.2, U104.47 (47_PC5)
IO_SPARE4: J105.3, U104.48 (48_PC4)
LED0: LED101.K, U104.52 (52_PC0)
LED1: LED102.K, U104.51 (51_PC1)
LED2: LED103.K, U104.50 (50_PC2)
LED3: LED104.K, U104.49 (49_PC3)
LED_SUB0: U104.34 (34_P12)
LED_SUB1: U104.33 (33_P13)
LEFT_MOTOR_CCW: U104.86 (86_PD0); also elsewhere on the board
LEFT_MOTOR_CW: U104.85 (85_PD1); also elsewhere on the board
LEFT_MOTOR_PWM: R137.P$1; also elsewhere on the board
LEFT_TCLKC: U104.26 (26_P22); also elsewhere on the board
LEFT_TCLKD: U104.25 (25_P23); also elsewhere on the board
MD/FINE: J101.7, R102.R2-A, U104.7 (7_MD/FINED)
unnamed: C108.P$1, U104.5 (5_VCL)
unnamed: C112.P$1, U104.11 (11_P37/XTAL), X101.3
unnamed: R131.P$1, U105.7 (!HOLD)
unnamed: R112.P$2, U101.5 (OUT)
unnamed: B101.+, D101.K, R112.P$1
unnamed: U103.3 (+IN), VR101.3, VR101.4
unnamed: R130.P$1, U105.3 (!WP)
unnamed: C113.P$1, U104.13 (13_P36/EXTAL), X101.1
unnamed: J104.5 (5_CLK), R124.R1-A
unnamed: J104.3 (3_DI/CMD), R124.R2-A
unnamed: J104.2 (2_-CS/DAT3), R124.R3-A
unnamed: R107.P$1, R110.P$2, U102.3 (+IN)
unnamed: J104.1 (1_NC/DAT2), R124.R4-A
unnamed: J104.8 (8_RSV/DAT1), R128.R3-A
unnamed: R134.P$2, U105.2 (DO)
unnamed: J104.7 (7_DO/DAT0), R128.R4-A
unnamed: LED101.A, R125.R1-A
unnamed: LED102.A, R125.R2-A
unnamed: LED103.A, R125.R3-A
unnamed: LED104.A, R125.R4-A
unnamed: J104.CD (CD1), R128.R2-A
unnamed: R132.R4-B, U104.84 (84_PD2)
unnamed: R132.R3-B, U104.83 (83_PD3)
unnamed: R132.R2-B, U104.82 (82_PD4)
unnamed: R132.R1-B, U104.81 (81_PD5)
unnamed: R135.P$2, U104.79 (79_PD7)
unnamed: R123.P$2, U104.57 (57_PB3)
unnamed: R117.P$1, U104.37 (37_USB0_DP)
unnamed: R118.P$1, U104.36 (36_USB0_DM)
PWM_BUZZER: R111.P$2, U101.3 (IN), U104.59 (59_PB1)
PWM_MOT1_MPU: R137.P$2, U104.77 (77_PE1)
PWM_MOT2_MPU: R138.P$2, U104.76 (76_PE2)
PWM_MOT3_MPU: R129.P$2, U104.46 (46_PC6)
PWM_SUB: R123.P$1
RESET: C117.P$1, D102.A, J101.13, R136.P$1, SW102.1, U104.10 (10_RES#)
RIGHT_MOTOR_CCW: U104.78 (78_PE0); also elsewhere on the board
RIGHT_MOTOR_CW: U104.75 (75_PE3); also elsewhere on the board
RIGHT_MOTOR_PWM: R138.P$1; also elsewhere on the board
RIGHT_TCLKA: U104.24 (24_P24); also elsewhere on the board
RIGHT_TCLKB: U104.23 (23_P25); also elsewhere on the board
RXD2_BTM: J103.3, R113.P$1, U104.43 (43_P51)
RXD9_OLED: J102.3, R108.P$1, U104.54 (54_PB6)
SCK2_BTM: U104.42 (42_P52)
SCK9_OLED: U104.55 (55_PB5)
SD_CD: R119.R3-B, R128.R2-B, U104.72 (72_PE6)
SD_CLK: R124.R1-B, R126.P$1, R132.R1-A
SD_CMD: R120.R3-B, R122.P$1, R124.R2-B, R132.R2-A
SD_DAT0: R119.R1-B, R127.P$1, R128.R4-B, R133.P$1
SD_DAT1: R119.R2-B, R128.R3-B, R135.P$1
SD_DAT2: R120.R1-B, R124.R4-B, R132.R4-A
SD_DAT3: R120.R2-B, R121.P$1, R124.R3-B, R132.R3-A
SD_WP: U104.71 (71_PE7)
SENSOR_MOTOR_CCW: U104.74 (74_PE4); also elsewhere on the board
SENSOR_MOTOR_CW: U104.61 (61_PB0); also elsewhere on the board
SENSOR_MOTOR_EN: U104.56 (56_PB4); also elsewhere on the board
SENSOR_MOTOR_PWM: R129.P$1; also elsewhere on the board
SEN_GATE: U104.32 (32_P14); also elsewhere on the board
SPI_CS0: U104.66 (66_PA4); also elsewhere on the board
SPI_CS1: U104.70 (70_PA0), U105.1 (!CS)
SPI_CS3: R121.P$2, U104.68 (68_PA2)
SPI_MISO: R127.P$2, R134.P$1, U104.63 (63_PA7); also elsewhere on the board
SPI_MOSI: R116.P$1, U105.5 (DI); also elsewhere on the board
SPI_SCK: R115.P$1, U105.6 (CLK); also elsewhere on the board
TACT_A: R103.R1-A, SW101.A, U104.28 (28_P20)
TACT_B: R103.R3-A, SW101.B, U104.29 (29_P17)
TACT_C: R104.P$1, SW101.C, U104.31 (31_P15)
TACT_CENTER: R103.R2-A, SW101.CENTER, U104.27 (27_P21)
TACT_D: R103.R4-A, SW101.D, U104.30 (30_P16)
TCK: J101.1, R101.P$1, U104.21 (21_P27/TCK)
TDI: J101.11, R102.R4-A, U104.20 (20_P30/TDI)
TDO: J101.5, R102.R1-A, U104.22 (22_P26/TDO)
TMS: J101.9, R102.R3-A, U104.19 (19_P31/TMS)
TRST#: J101.3, R105.P$2, U104.16 (16_P34/TRST#)
TXD2_BTM: J103.2, R114.P$1, U104.44 (44_P50)
TXD9_OLED: J102.2, R109.P$1, U104.53 (53_PB7)
UB: J101.10, U104.45 (45_PC7/UB)
UPSEL_NMI: R139.P$2, R140.P$1, U104.15 (15_P35/UPSEL/NMI)
USB0_DM: R118.P$2
USB0_DP: R117.P$2

Notes on the sheet:
oLED
E1 Emulator
RX64M TxD -> OLED RxD
RX64M RxD <- OLED TxD
BTmodule
UP : B RIGHT : D DOWN : C LEFT : A CENTER : CENTER
LEFT MOTOR
RIGHT MOTOR
1. TCK 2. GND 3. TRST# 4. EMLE 5. TDO 6. NC 7. MD/FINED 8. VCC 9. TMS 10. UB 11. TDI 12. GND 13. RES# 14. GND
for Power Control Spare
for I/O Control Spare

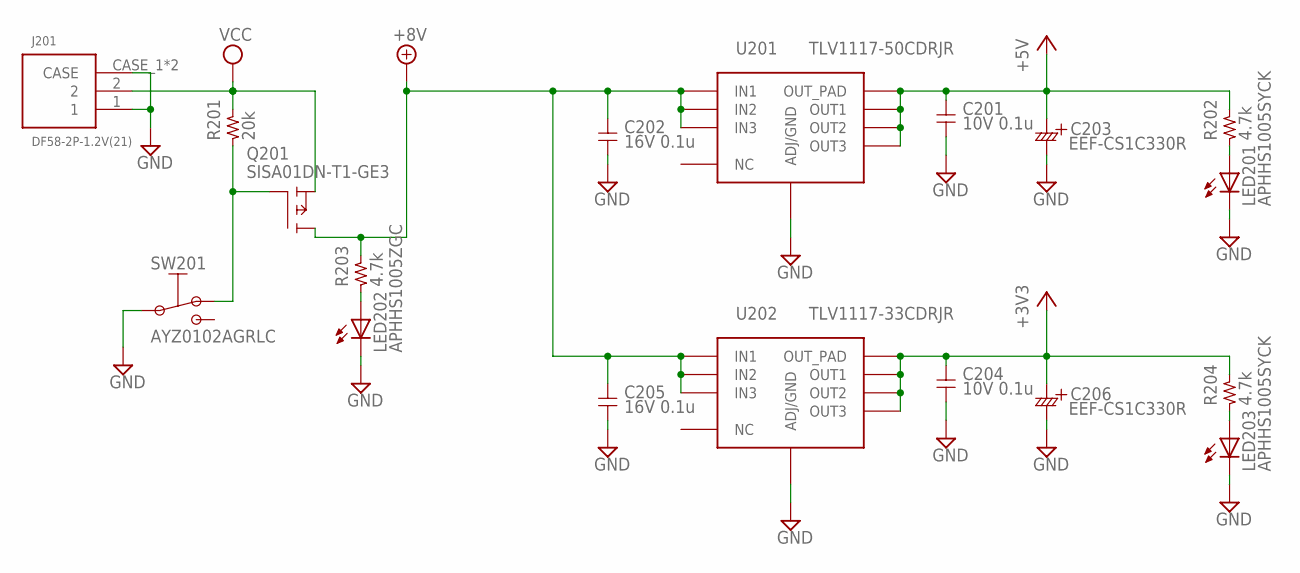
[picture p12: schematic VerdiRT7_MainPCB.sch, sheet 2]

Parts:
C201, C204: 10V 0.1u; 1005
C202, C205: 16V 0.1u; 1005
C203, C206: EEF-CS1C330R; EEFC_7343
J201: DF58-2P-1.2V(21); DF58_2P
LED201, LED203: APHHS1005SYCK; 1005
LED202: APHHS1005ZGC; 1005
Q201: SISA01DN-T1-GE3; POWERPAK1212-8
R201: 20k; 1005
R202, R203, R204: 4.7k; 1005
SW201: AYZ0102AGRLC
U201: TLV1117-50CDRJR; WFDFN8
U202: TLV1117-33CDRJR; WFDFN8

Connections:
+3V3: C204.P$1, C206.PLUS, R204.P$2, U202.5 (OUT1), U202.6 (OUT2), U202.7 (OUT3), U202.PAD (OUT_PAD); also elsewhere on the board
+5V: C201.P$1, C203.PLUS, R202.P$2, U201.5 (OUT1), U201.6 (OUT2), U201.7 (OUT3), U201.PAD (OUT_PAD); also elsewhere on the board
+8V: C202.P$1, C205.P$1, Q201.5 (D), Q201.9 (D), R203.P$2, U201.2 (IN1), U201.3 (IN2), U201.4 (IN3), U202.2 (IN1), U202.3 (IN2), U202.4 (IN3); also elsewhere on the board
GND: C201.P$2, C202.P$2, C203.MINUS, C204.P$2, C205.P$2, C206.MINUS, J201.1, J201.CASE_1 (CASE), J201.CASE_2 (CASE), LED201.K, LED202.K, LED203.K, SW201.2, U201.1 (ADJ/GND), U202.1 (ADJ/GND); also elsewhere on the board
unnamed: Q201.4 (G), R201.P$1, SW201.1
unnamed: LED202.A, R203.P$1
unnamed: LED201.A, R202.P$1
unnamed: LED203.A, R204.P$1
VCC: J201.2, Q201.1 (S), R201.P$2

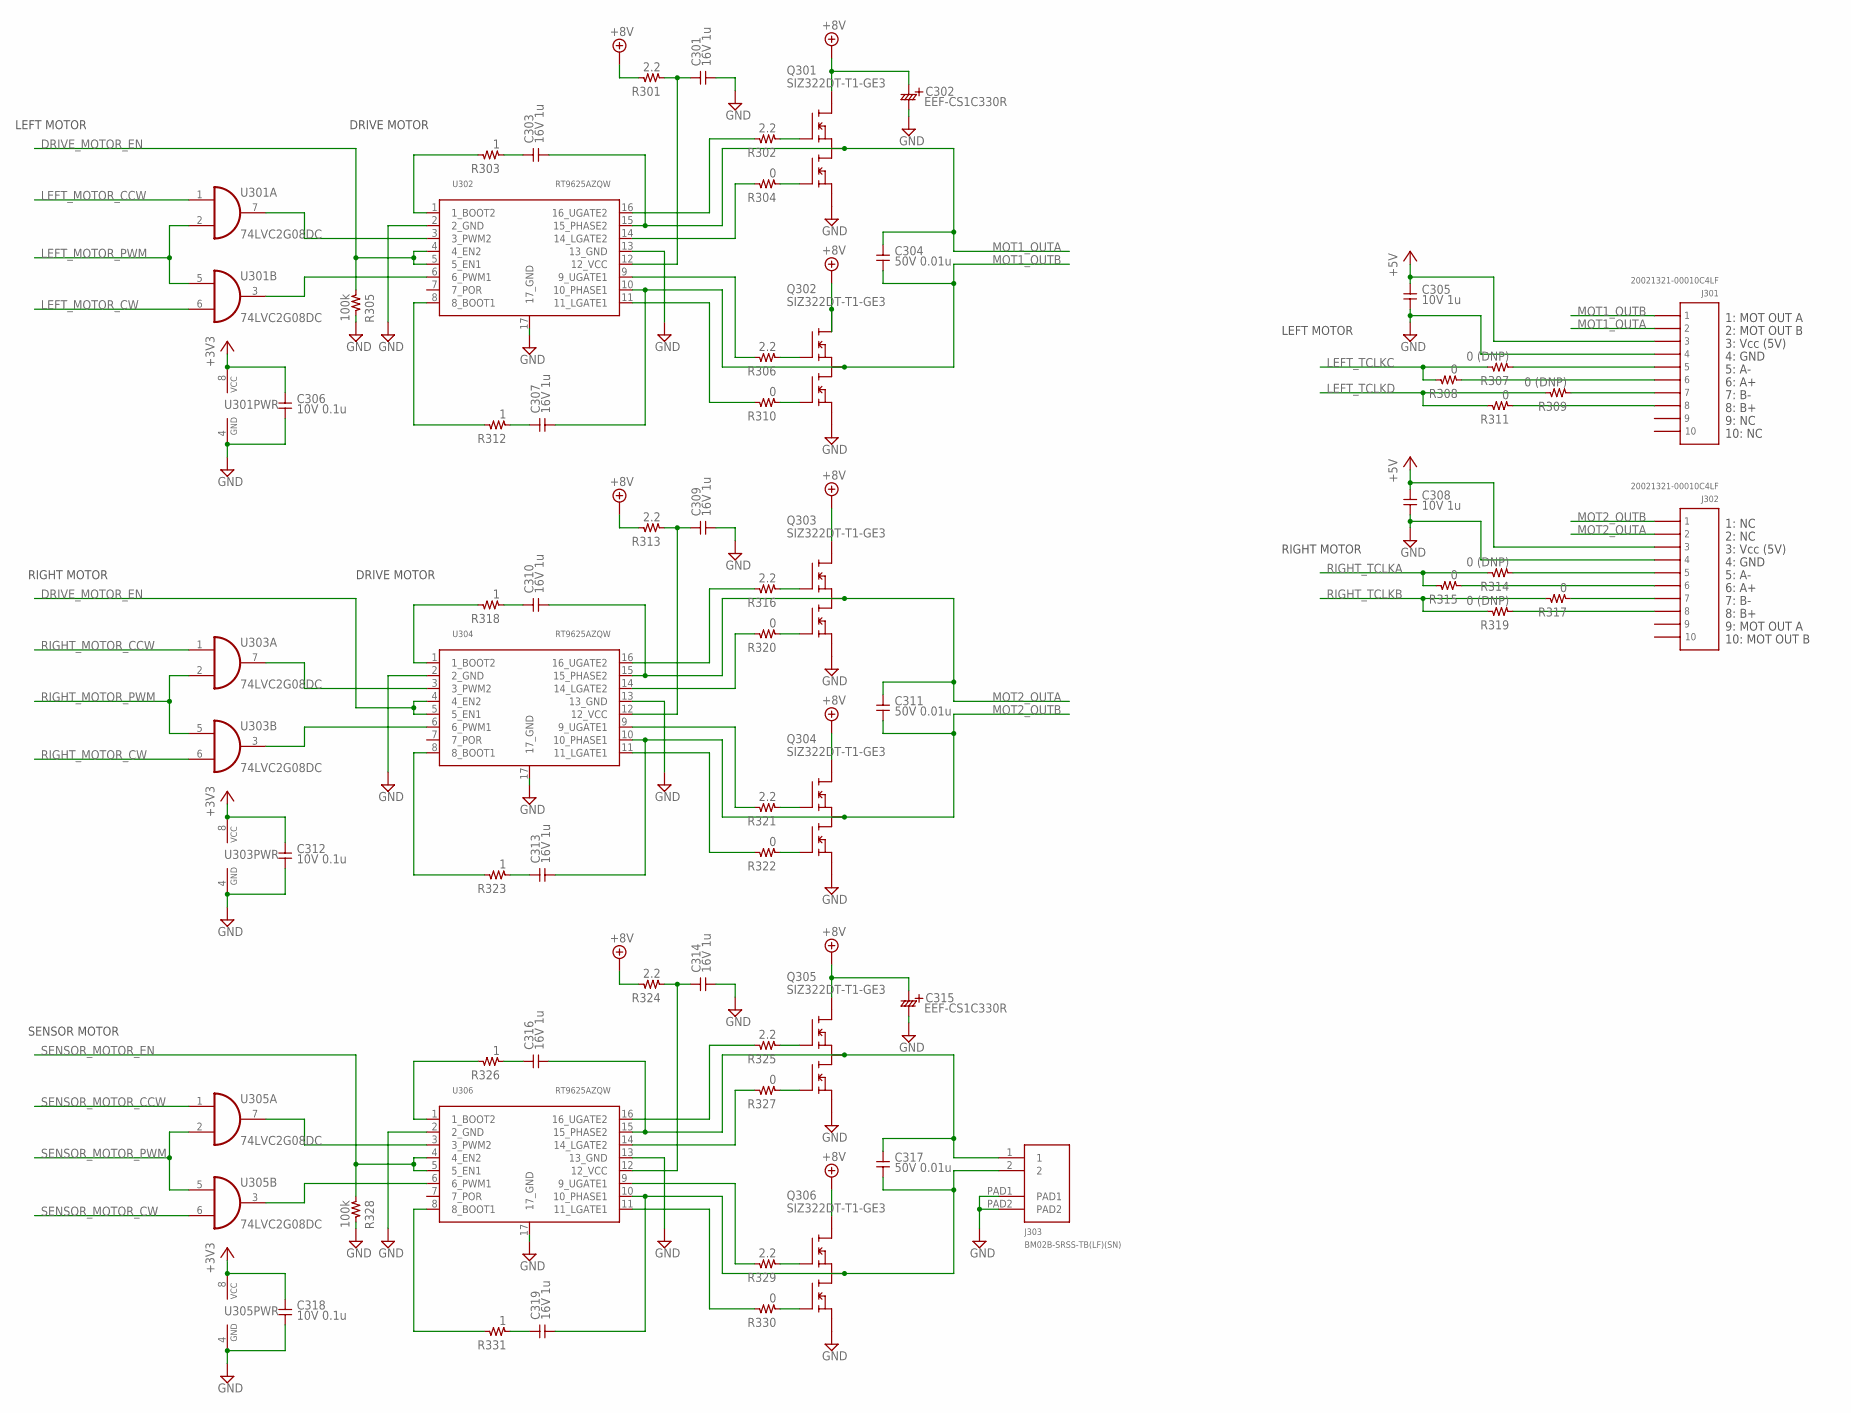
[picture p13: schematic VerdiRT7_MainPCB.sch, sheet 3]

Parts:
C301, C303, C307, C309, C310, C313, C314, C316, C319: 16V 1u; 1005
C302, C315: EEF-CS1C330R; EEFC_7343
C304, C311, C317: 50V 0.01u; 1005
C305, C308: 10V 1u; 1005
C306, C312, C318: 10V 0.1u; 1005
J301, J302: 20021321-00010C4LF; MA5-2_SMD_1.27MM_MIN
J303: BM02B-SRSS-TB(LF)(SN); BM02B-SRSS-TB
Q301, Q302, Q303, Q304, Q305, Q306: SIZ322DT-T1-GE3; DFN3X3A
R301, R302, R306, R313, R316, R321, R324, R325, R329: 2.2; 1005
R303, R312, R318, R323, R326, R331: 1; 1005
R304, R308, R310, R311, R315, R317, R320, R322, R327, R330: 0; 1005
R305, R328: 100k; 1005
R307, R309, R314, R319: 0 (DNP); 1005
U301, U303, U305: 74LVC2G08DC; VSSOP8
U302, U304, U306: RT9625AZQW; WQFN16

Connections:
1_A+: J302.6, R315.P$1
1_A-: J302.5, R314.P$1
2_B+: J302.8, R319.P$1
2_B-: J302.7, R317.P$1
3_A+: J301.6, R308.P$1
3_A-: J301.5, R307.P$1
4_B+: J301.8, R311.P$1
4_B-: J301.7, R309.P$1
+3V3: C306.P$1, C312.P$1, C318.P$1, U301.8 (VCC), U303.8 (VCC), U305.8 (VCC); also elsewhere on the board
+5V: C305.P$1, C308.P$1, J301.3, J302.3; also elsewhere on the board
+8V: C302.PLUS, C315.PLUS, Q301.2 (D1), Q301.3 (D1), Q301.4 (D1), Q301.PAD_S (D1), Q302.2 (D1), Q302.3 (D1), Q302.4 (D1), Q302.PAD_S (D1), Q303.2 (D1), Q303.3 (D1), Q303.4 (D1), Q303.PAD_S (D1), Q304.2 (D1), Q304.3 (D1), Q304.4 (D1), Q304.PAD_S (D1), Q305.2 (D1), Q305.3 (D1), Q305.4 (D1), Q305.PAD_S (D1), Q306.2 (D1), Q306.3 (D1), Q306.4 (D1), Q306.PAD_S (D1), R301.P$2, R313.P$2, R324.P$2; also elsewhere on the board
DRIVE_MOTOR_EN: R305.P$1, U302.4 (4_EN2), U302.5 (5_EN1), U304.4 (4_EN2), U304.5 (5_EN1); also elsewhere on the board
GND: C301.P$2, C302.MINUS, C305.P$2, C306.P$2, C308.P$2, C309.P$2, C312.P$2, C314.P$2, C315.MINUS, C318.P$2, J301.4, J302.4, J303.PAD1, J303.PAD2, Q301.5 (S2), Q301.6 (S2), Q301.7 (S2), Q302.5 (S2), Q302.6 (S2), Q302.7 (S2), Q303.5 (S2), Q303.6 (S2), Q303.7 (S2), Q304.5 (S2), Q304.6 (S2), Q304.7 (S2), Q305.5 (S2), Q305.6 (S2), Q305.7 (S2), Q306.5 (S2), Q306.6 (S2), Q306.7 (S2), R305.P$2, R328.P$2, U301.4 (GND), U302.2 (2_GND), U302.13 (13_GND), U302.17 (17_GND), U303.4 (GND), U304.2 (2_GND), U304.13 (13_GND), U304.17 (17_GND), U305.4 (GND), U306.2 (2_GND), U306.13 (13_GND), U306.17 (17_GND); also elsewhere on the board
LEFT_MOTOR_CCW: U301.1 (I0); also elsewhere on the board
LEFT_MOTOR_CW: U301.6 (I1); also elsewhere on the board
LEFT_MOTOR_PWM: U301.2 (I1), U301.5 (I0); also elsewhere on the board
LEFT_TCLKC: R307.P$2, R308.P$2; also elsewhere on the board
LEFT_TCLKD: R309.P$2, R311.P$2; also elsewhere on the board
MOT1_OUTA: C303.P$2, C304.P$1, J301.2, Q301.PAD_L (S1D2), U302.15 (15_PHASE2)
MOT1_OUTB: C304.P$2, C307.P$2, J301.1, Q302.PAD_L (S1D2), U302.10 (10_PHASE1)
MOT2_OUTA: C310.P$2, C311.P$1, J302.2, Q303.PAD_L (S1D2), U304.15 (15_PHASE2)
MOT2_OUTB: C311.P$2, C313.P$2, J302.1, Q304.PAD_L (S1D2), U304.10 (10_PHASE1)
unnamed: C317.P$2, C319.P$2, J303.2, Q306.PAD_L (S1D2), U306.10 (10_PHASE1)
unnamed: Q306.1 (G1), R329.P$1
unnamed: Q306.8 (G2), R330.P$1
unnamed: R318.P$2, U304.1 (1_BOOT2)
unnamed: C310.P$1, R318.P$1
unnamed: R323.P$2, U304.8 (8_BOOT1)
unnamed: C313.P$1, R323.P$1
unnamed: C309.P$1, R313.P$1, U304.12 (12_VCC)
unnamed: U303.7 (O), U304.3 (3_PWM2)
unnamed: U303.3 (O), U304.6 (6_PWM1)
unnamed: R322.P$2, U304.11 (11_LGATE1)
unnamed: R321.P$2, U304.9 (9_UGATE1)
unnamed: R320.P$2, U304.14 (14_LGATE2)
unnamed: Q303.8 (G2), R320.P$1
unnamed: R316.P$2, U304.16 (16_UGATE2)
unnamed: Q303.1 (G1), R316.P$1
unnamed: Q304.1 (G1), R321.P$1
unnamed: Q304.8 (G2), R322.P$1
unnamed: R303.P$2, U302.1 (1_BOOT2)
unnamed: C303.P$1, R303.P$1
unnamed: R312.P$2, U302.8 (8_BOOT1)
unnamed: C307.P$1, R312.P$1
unnamed: C301.P$1, R301.P$1, U302.12 (12_VCC)
unnamed: U301.7 (O), U302.3 (3_PWM2)
unnamed: U301.3 (O), U302.6 (6_PWM1)
unnamed: R310.P$2, U302.11 (11_LGATE1)
unnamed: R306.P$2, U302.9 (9_UGATE1)
unnamed: R304.P$2, U302.14 (14_LGATE2)
unnamed: Q301.8 (G2), R304.P$1
unnamed: R326.P$2, U306.1 (1_BOOT2)
unnamed: C316.P$1, R326.P$1
unnamed: C316.P$2, C317.P$1, J303.1, Q305.PAD_L (S1D2), U306.15 (15_PHASE2)
unnamed: R331.P$2, U306.8 (8_BOOT1)
unnamed: C319.P$1, R331.P$1
unnamed: R302.P$2, U302.16 (16_UGATE2)
unnamed: C314.P$1, R324.P$1, U306.12 (12_VCC)
unnamed: U305.7 (O), U306.3 (3_PWM2)
unnamed: U305.3 (O), U306.6 (6_PWM1)
unnamed: R330.P$2, U306.11 (11_LGATE1)
unnamed: Q301.1 (G1), R302.P$1
unnamed: R327.P$2, U306.14 (14_LGATE2)
unnamed: R329.P$2, U306.9 (9_UGATE1)
unnamed: Q305.8 (G2), R327.P$1
unnamed: R325.P$2, U306.16 (16_UGATE2)
unnamed: Q305.1 (G1), R325.P$1
unnamed: Q302.1 (G1), R306.P$1
unnamed: Q302.8 (G2), R310.P$1
RIGHT_MOTOR_CCW: U303.1 (I0); also elsewhere on the board
RIGHT_MOTOR_CW: U303.6 (I1); also elsewhere on the board
RIGHT_MOTOR_PWM: U303.2 (I1), U303.5 (I0); also elsewhere on the board
RIGHT_TCLKA: R314.P$2, R315.P$2; also elsewhere on the board
RIGHT_TCLKB: R317.P$2, R319.P$2; also elsewhere on the board
SENSOR_MOTOR_CCW: U305.1 (I0); also elsewhere on the board
SENSOR_MOTOR_CW: U305.6 (I1); also elsewhere on the board
SENSOR_MOTOR_EN: R328.P$1, U306.4 (4_EN2), U306.5 (5_EN1); also elsewhere on the board
SENSOR_MOTOR_PWM: U305.2 (I1), U305.5 (I0); also elsewhere on the board

Notes on the sheet:
SENSOR MOTOR
DRIVE MOTOR
3: Vcc (5V)
4: GND
5: A-
6: A+
7: B-
8: B+
2: MOT OUT B
1: MOT OUT A
9: NC
10: NC
2: NC
1: NC
9: MOT OUT A
10: MOT OUT B
RIGHT MOTOR
LEFT MOTOR

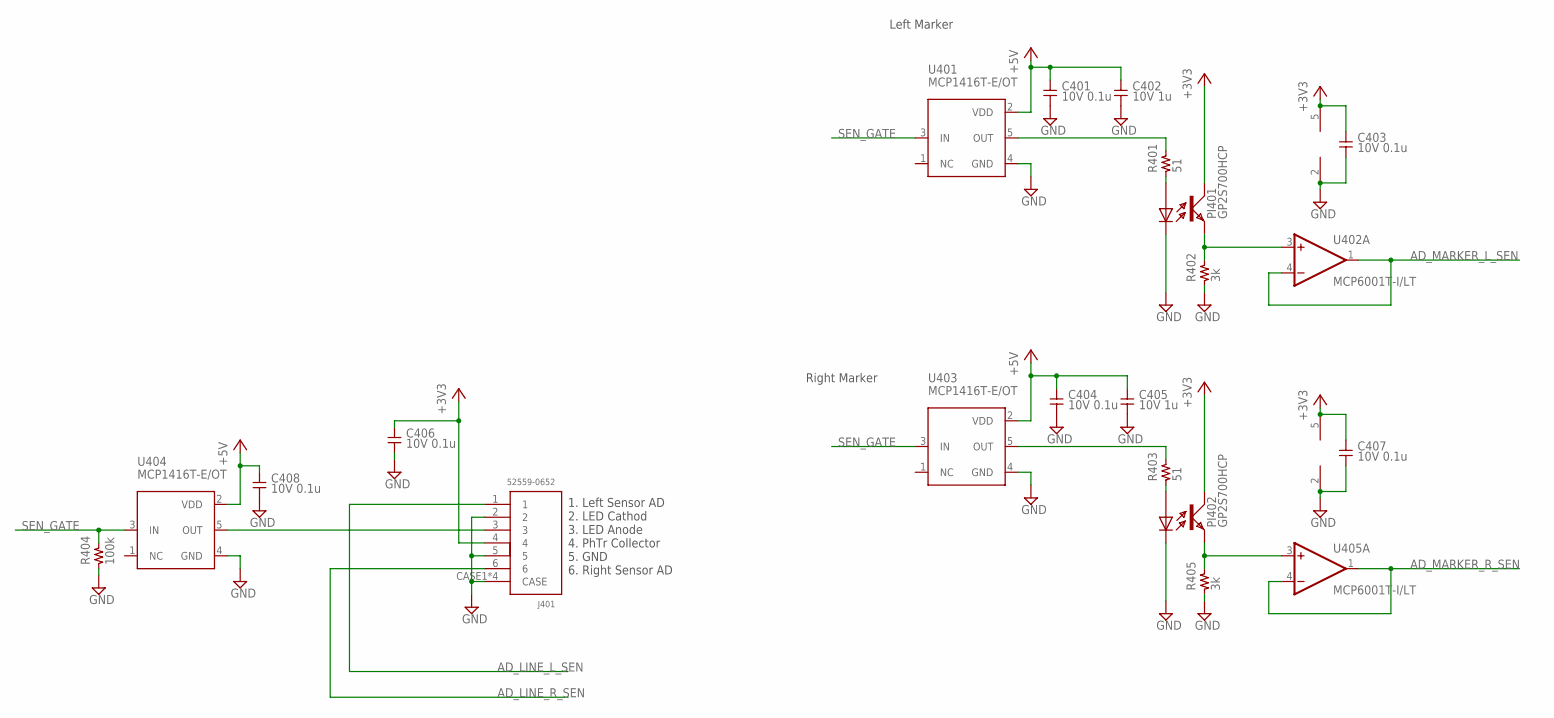
[picture p14: schematic VerdiRT7_MainPCB.sch, sheet 4]

Parts:
C401, C403, C404, C406, C407, C408: 10V 0.1u; 1005
C402, C405: 10V 1u; 1005
J401: 52559-0652; 0652
PI401, PI402: GP2S700HCP; GP2S700
R401, R403: 51; 1608
R402, R405: 3k; 1005
R404: 100k; 1005
U401, U403, U404: MCP1416T-E/OT; SOT23-5
U402, U405: MCP6001T-I/LT; SOT-70-5

Connections:
+3V3: C403.P$1, C406.P$1, C407.P$1, J401.4, PI401.COLLECTOR, PI402.COLLECTOR, U402.5 (V+), U405.5 (V+); also elsewhere on the board
+5V: C401.P$1, C402.P$1, C404.P$1, C405.P$1, C408.P$1, U401.2 (VDD), U403.2 (VDD), U404.2 (VDD); also elsewhere on the board
AD_LINE_L_SEN: J401.1; also elsewhere on the board
AD_LINE_R_SEN: J401.6; also elsewhere on the board
AD_MARKER_L_SEN: U402.1 (OUT), U402.4 (-IN); also elsewhere on the board
AD_MARKER_R_SEN: U405.1 (OUT), U405.4 (-IN); also elsewhere on the board
GND: C401.P$2, C402.P$2, C403.P$2, C404.P$2, C405.P$2, C406.P$2, C407.P$2, C408.P$2, J401.2, J401.5, J401.CASE1 (CASE), J401.CASE2 (CASE), J401.CASE3 (CASE), J401.CASE4 (CASE), PI401.CATHODE, PI402.CATHODE, R402.P$1, R404.P$1, R405.P$1, U401.4 (GND), U402.2 (V-), U403.4 (GND), U404.4 (GND), U405.2 (V-); also elsewhere on the board
unnamed: J401.3, U404.5 (OUT)
unnamed: R401.P$2, U401.5 (OUT)
unnamed: PI401.ANODE, R401.P$1
unnamed: PI401.EMITTER, R402.P$2, U402.3 (+IN)
unnamed: R403.P$2, U403.5 (OUT)
unnamed: PI402.ANODE, R403.P$1
unnamed: PI402.EMITTER, R405.P$2, U405.3 (+IN)
SEN_GATE: R404.P$2, U401.3 (IN), U403.3 (IN), U404.3 (IN); also elsewhere on the board

Notes on the sheet:
Left Marker
Right Marker
1. Left Sensor AD 2. LED Cathod 3. LED Anode 4. PhTr Collector 5. GND 6. Right Sensor AD

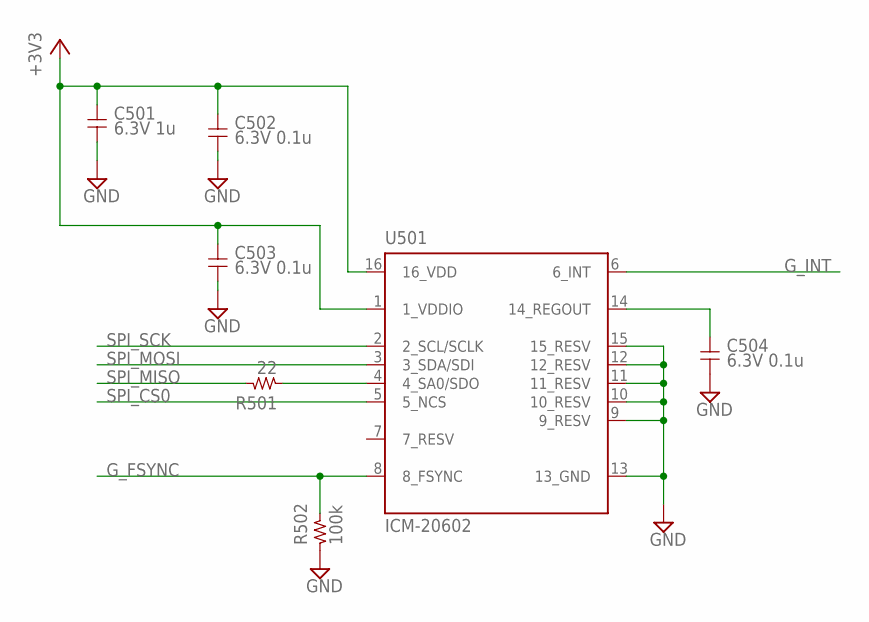
[picture p15: schematic VerdiRT7_MainPCB.sch, sheet 5]

Parts:
C501: 6.3V 1u; 1005
C502, C503, C504: 6.3V 0.1u; 1005
R501: 22; 1005
R502: 100k; 1005
U501: ICM-20602; LGA16_3X3MM

Connections:
7_RESV: U501.7 (7_RESV)
+3V3: C501.P$1, C502.P$1, C503.P$1, U501.1 (1_VDDIO), U501.16 (16_VDD); also elsewhere on the board
GND: C501.P$2, C502.P$2, C503.P$2, C504.P$2, R502.P$1, U501.9 (9_RESV), U501.10 (10_RESV), U501.11 (11_RESV), U501.12 (12_RESV), U501.13 (13_GND), U501.15 (15_RESV); also elsewhere on the board
G_FSYNC: R502.P$2, U501.8 (8_FSYNC); also elsewhere on the board
G_INT: U501.6 (6_INT); also elsewhere on the board
unnamed: C504.P$1, U501.14 (14_REGOUT)
unnamed: R501.P$1, U501.4 (4_SA0/SDO)
SPI_CS0: U501.5 (5_NCS); also elsewhere on the board
SPI_MISO: R501.P$2; also elsewhere on the board
SPI_MOSI: U501.3 (3_SDA/SDI); also elsewhere on the board
SPI_SCK: U501.2 (2_SCL/SCLK); also elsewhere on the board

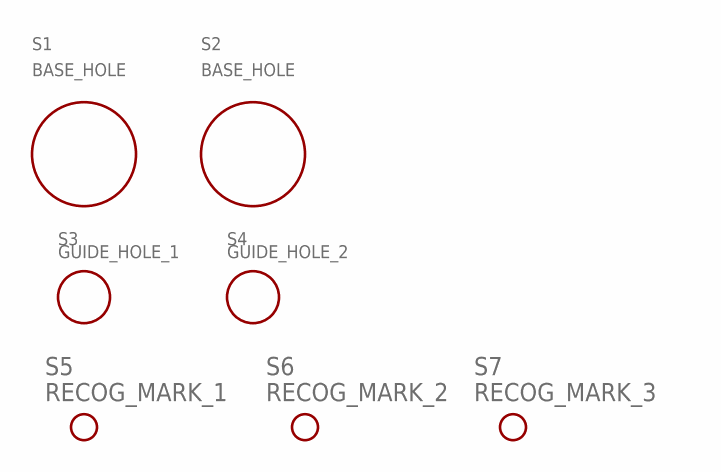
[picture p16: schematic VerdiRT7_MainPCB.sch, sheet 6]

Parts:
S1, S2: BASE_HOLE
S3: GUIDE_HOLE_1; GUIDE_HOLE
S4: GUIDE_HOLE_2; GUIDE_HOLE
S5: RECOG_MARK_1; RECOG_MARK
S6: RECOG_MARK_2; RECOG_MARK
S7: RECOG_MARK_3; RECOG_MARK

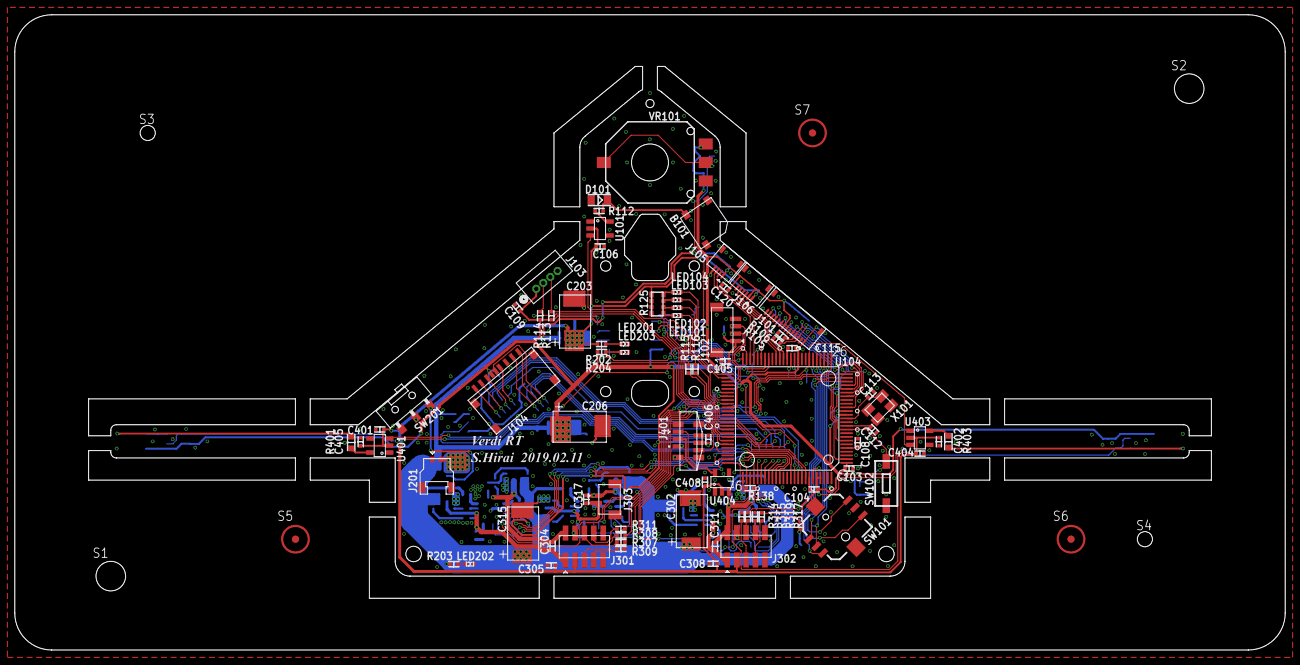
[picture p17: board VerdiRT7_MainPCB.brd from above]

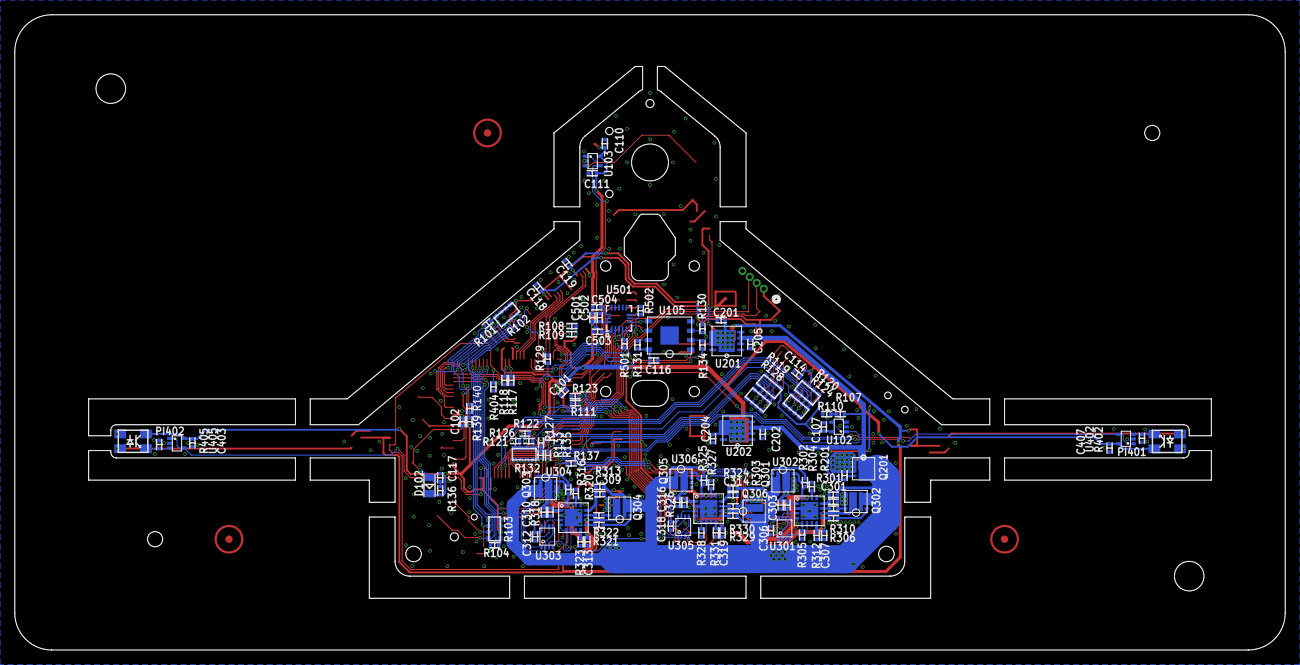
[picture p18: board VerdiRT7_MainPCB.brd from below]

Board: 2 copper layers, 172.0 x 86.0 mm, 200 parts (116 on the bottom side), 178 nets.
