penhirai/LinefollowerVerdiRT17_MainPCB/(commit log)

2018-07-17 added: Eagle Project and Logo, Gerber Data
    [VerdiRT7_MainPCB.brd, VerdiRT7_MainPCB.sch, VerdiRT7_RX64Mピンアサイン.xlsx]
2018-08-25 updated: AD0 モジュール使用によるピンアサイン変更 P05, P07 を使用しない
    [VerdiRT7_MainPCB.brd, VerdiRT7_MainPCB.sch, VerdiRT7_RX64Mピンアサイン.xlsx]
2018-09-30 updated: schematic にコメント挿入
    [VerdiRT7_MainPCB.brd, VerdiRT7_MainPCB.sch, VerdiRT7_RX64Mピンアサイン.xlsx]
2018-10-01 updated: Bluetooth モジュールの電源を+5V -> +3.3V に変更
    [VerdiRT7_MainPCB.brd, VerdiRT7_MainPCB.sch]
2019-01-09 updated: コネクタ変更，ディスコンFET 交換
    [VerdiRT7_MainPCB.brd, VerdiRT7_MainPCB.sch]
2019-01-09 updated: schema, board のPDF を追加
2019-01-26 updated: DRC 終了
    [VerdiRT7_MainPCB.brd, VerdiRT7_MainPCB.sch]
2019-01-26 updated: DRC 後のPDF 更新
2019-02-10 updated: リナンバー完了，BOM 完了
    [VerdiRT7_MainPCB.brd, VerdiRT7_MainPCB.sch]
2019-02-10 updated: ファイル構成変更
2019-02-10 updated: PDF 更新
2019-02-10 updated: BOM 追加
    [Bom_VerdiRT7_MainPCB.xlsx]
2019-02-17 updated: 捨て基板や認識マークを追加．発注データ作成
    [BomVerdiRT19_MainPCB.xlsx, Bom_VerdiRT7_MainPCB.xlsx, VerdiRT7_MainPCB.brd, VerdiRT7_MainPCB.sch]
